researchanddesire/rad-project-template/hardware/cad/README.md

# CAD

Place mechanical source files and exports for PRODUCT_NAME here.

Prefer source files or reproducible exports that can be linked from
`hardware/bom.csv`.
