researchanddesire/rad-project-template/developer-docs/docs/index.md

# Buttplug Compass

Start with the [manufacturing design proposal](prototype-build-handoff.md).
It replaces the earlier scaffold with four main mechanical pieces: CNC-turned body,
CNC-turned motor/thermistor cap, open flange tray and rear cover. A separate silicone boot
and standard insulation/foam remain part of the assembly.

| Page | Use it for |
| --- | --- |
| [Design proposal](prototype-build-handoff.md) | Current structure, assembly and unresolved interfaces |
| [Requirements](prd.md) | Lucy's feature and packaging constraints |
| [Architecture](architecture.md) | Mechanical, power and signal paths |
| [Hardware](hardware.md) | Current native CAD, exports and electrical references |
| [Firmware](firmware.md) | Existing bench code and compatibility limits |
| [Validation](testing.md) | Evidence, limits and required next checks |

The previous P1 dry-fit kit is withdrawn as the recommended build. The new CAD
is a manufacturing study, not a build/tooling release. Battery choice is open.
No physical build, powered operation or wear validation exists.

[Archived studies](archive/index.md) are for targeted historical lookup.
Update these current pages in place; use Git history rather than revision logs.
