researchanddesire/rad-project-template/developer-docs/docs/archive/index.md

---
search:
  exclude: true
---

# Archived design studies

These are dated snapshots, superseded concepts and detailed investigation
records. Their phrases such as “current” or “latest” refer to the time they
were written. They do not override the [current build proposal](../prototype-build-handoff.md).

| Topic | Selected historical records |
| --- | --- |
| Shape and construction | [Pelvic contour](design-proposal-v3.md), [metal/polymer direction](materials-and-rf-study.md) |
| One-piece/front loading | [R9](front-load-study-r9.md), [carrier](front-load-carrier-r10.md) |
| Independent motor and tip | [Shell mount](motor-shell-mount-r25.md), [stationary tip](tip-support-r26.md) |
| Boards and interconnect | [Split circuit](split-circuit-r14.md), [pack lands](pack-connection-r34.md) |
| Flange, controls and battery | [Rotated cradle](flange-cradle-r27.md), [buttons](buttons-r31.md), [pack tray](flange-pack-r33.md) |
| Superseded retention | [Shared motor/PCB keeper](motor-retention-r21.md), [sensor comb](sensor-retention-r38.md) |

Other revision pages are retained in this folder for targeted lookup and are
excluded from normal site search/navigation. Old source paths and hash manifests
may describe the pre-cleanup tree; use Git history for that snapshot. Native
hardware sources remain under `hardware/`, not in this documentation archive.

Do not copy this history back into current pages or append a running revision
log. Update the current design in place; Git records those changes. Some notes
were still uncommitted during cleanup, so they are preserved here rather than
assuming they already exist in Git history.
