researchanddesire/rad-project-template/developer-docs/docs/assets/compass-prd-layout-fixed.png

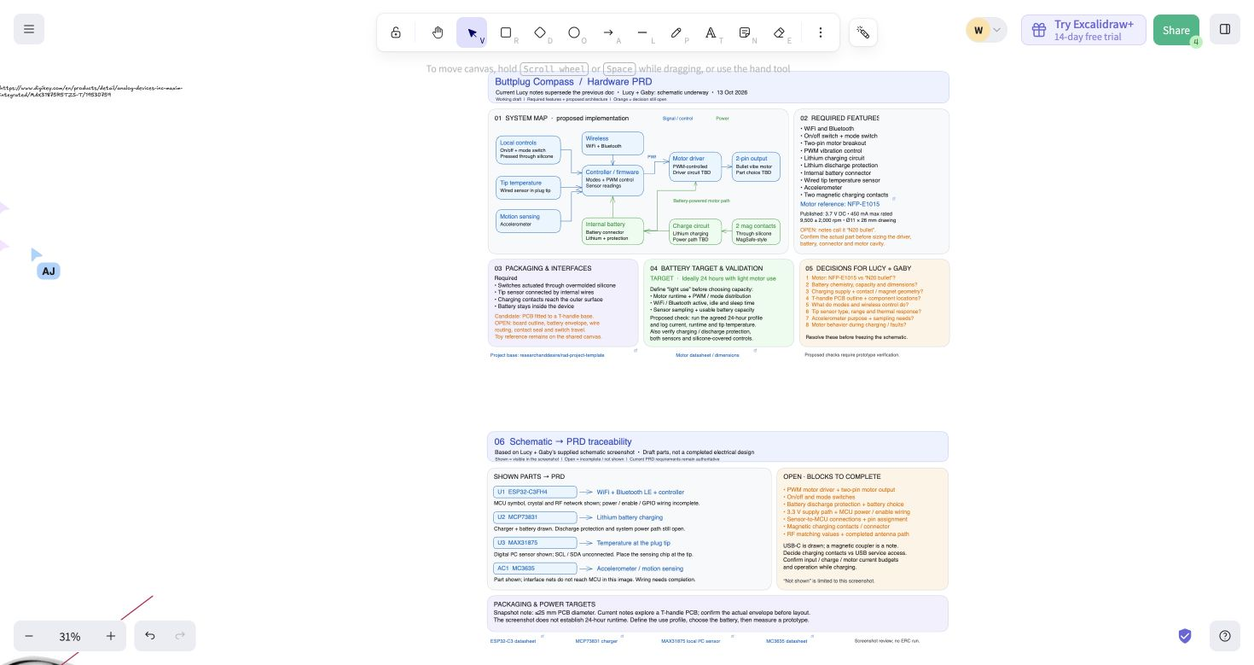
developer-docs/docs/assets/compass-prd-layout-fixed.png
