researchanddesire/rad-project-template/developer-docs/docs/assets/concept-v3/contour-v3.png

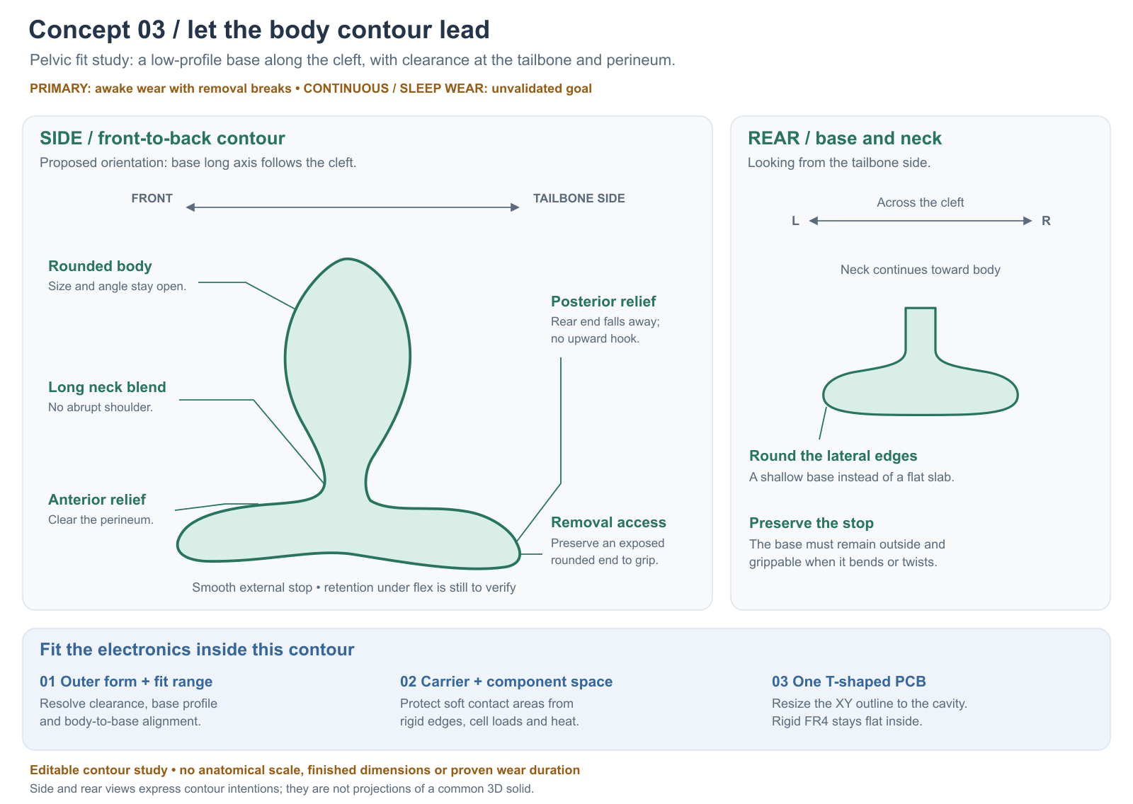
developer-docs/docs/assets/concept-v3/contour-v3.png
