researchanddesire/rad-project-template/developer-docs/docs/assets/prototype-p1-cover.png

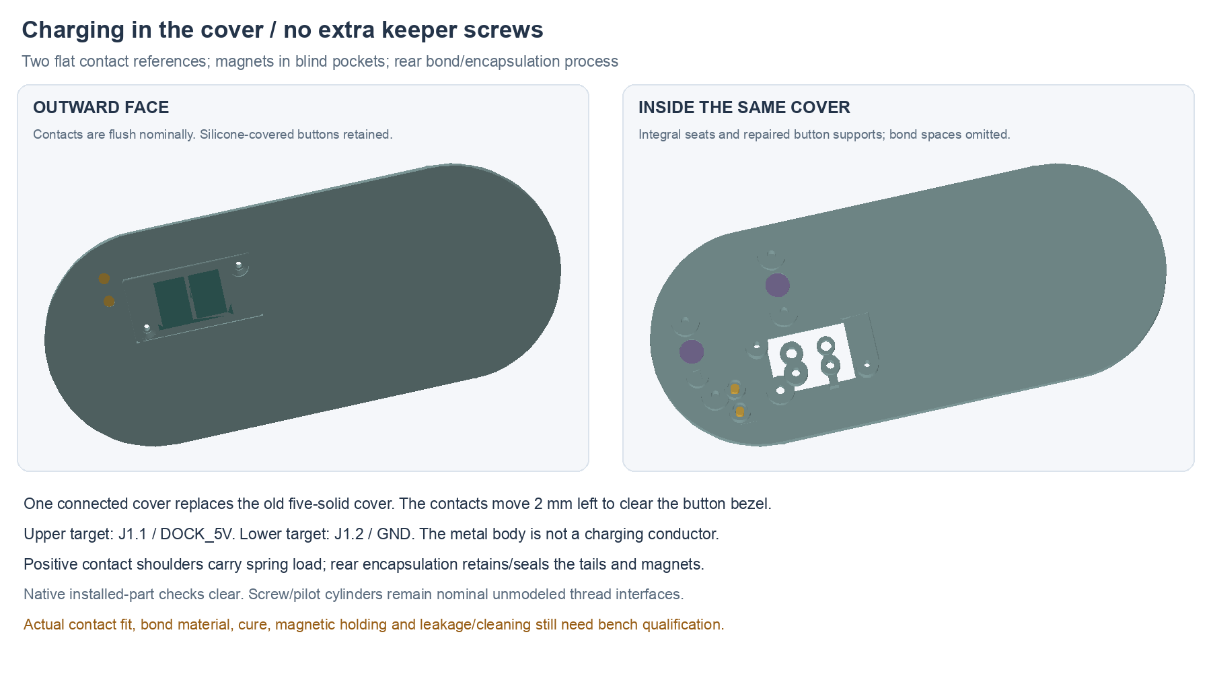
developer-docs/docs/assets/prototype-p1-cover.png
