researchanddesire/rad-project-template/developer-docs/docs/assets/prototype-p1-dry-fit.png

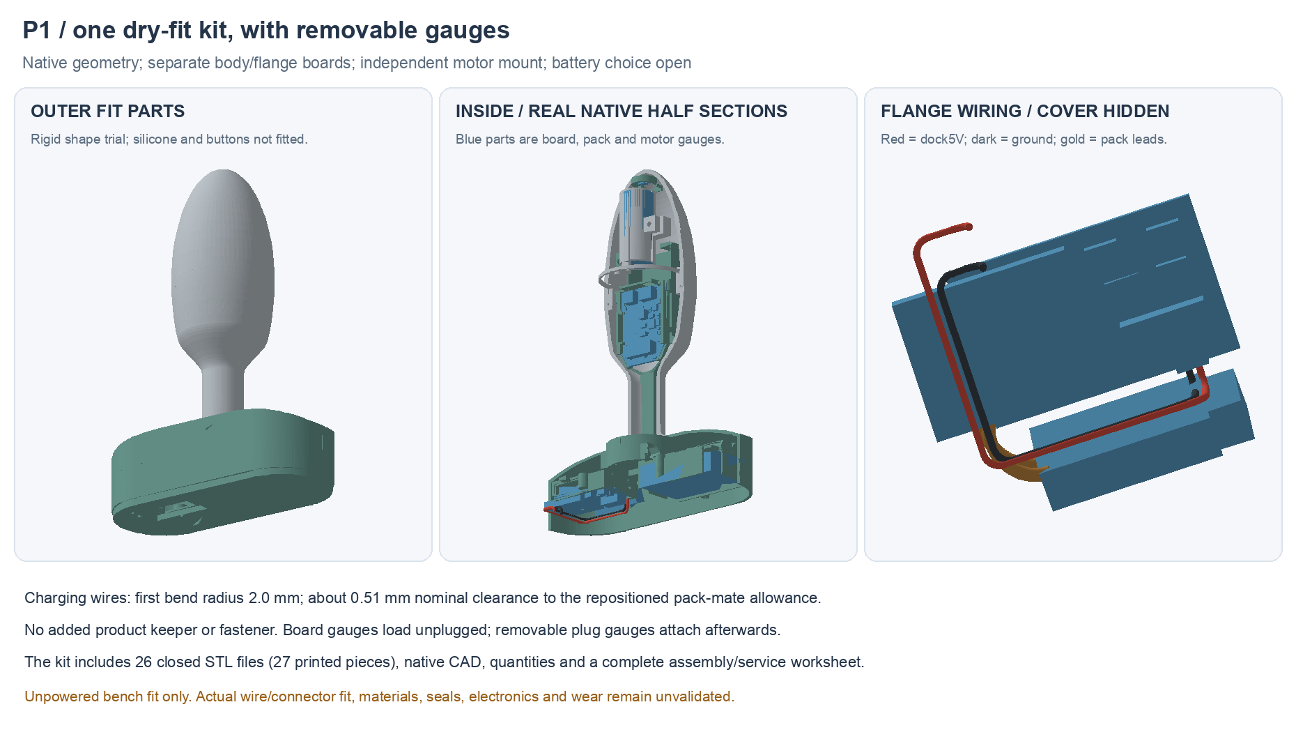
developer-docs/docs/assets/prototype-p1-dry-fit.png
