researchanddesire/rad-project-template/developer-docs/docs/assets/prototype-p1.png

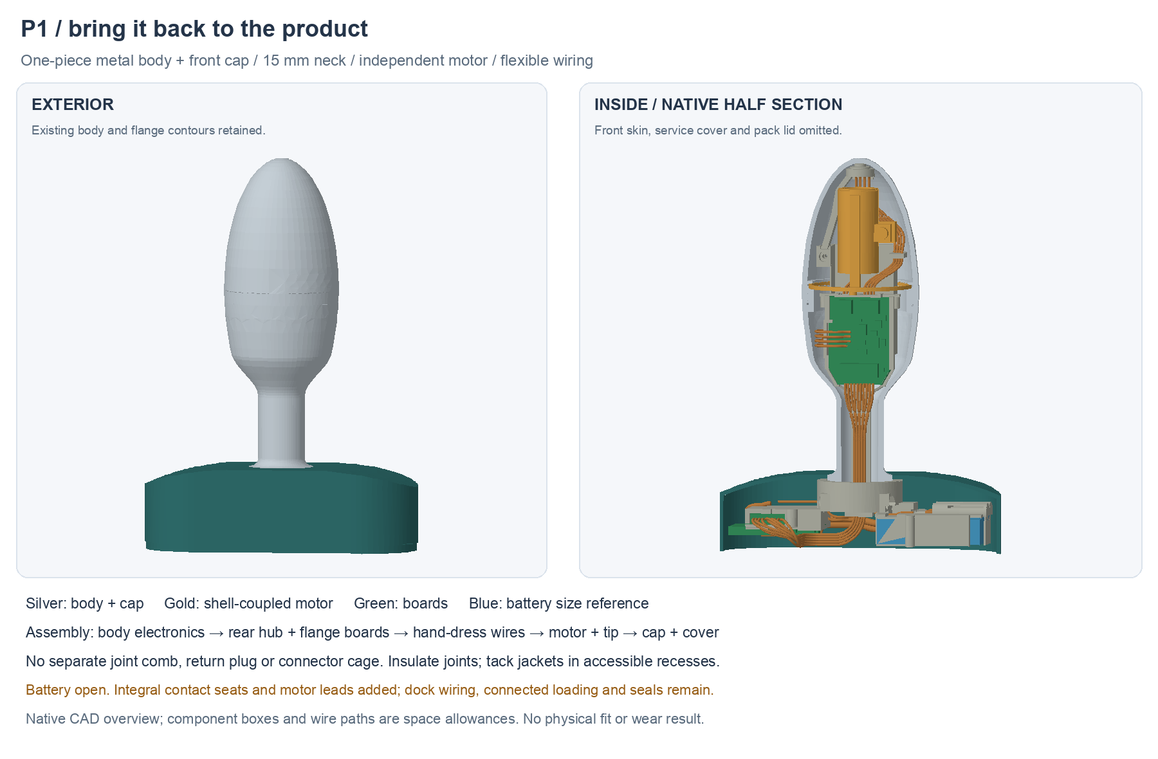
developer-docs/docs/assets/prototype-p1.png
