researchanddesire/rad-project-template/developer-docs/docs/assets/prototype-r0/mechanical-r0.png

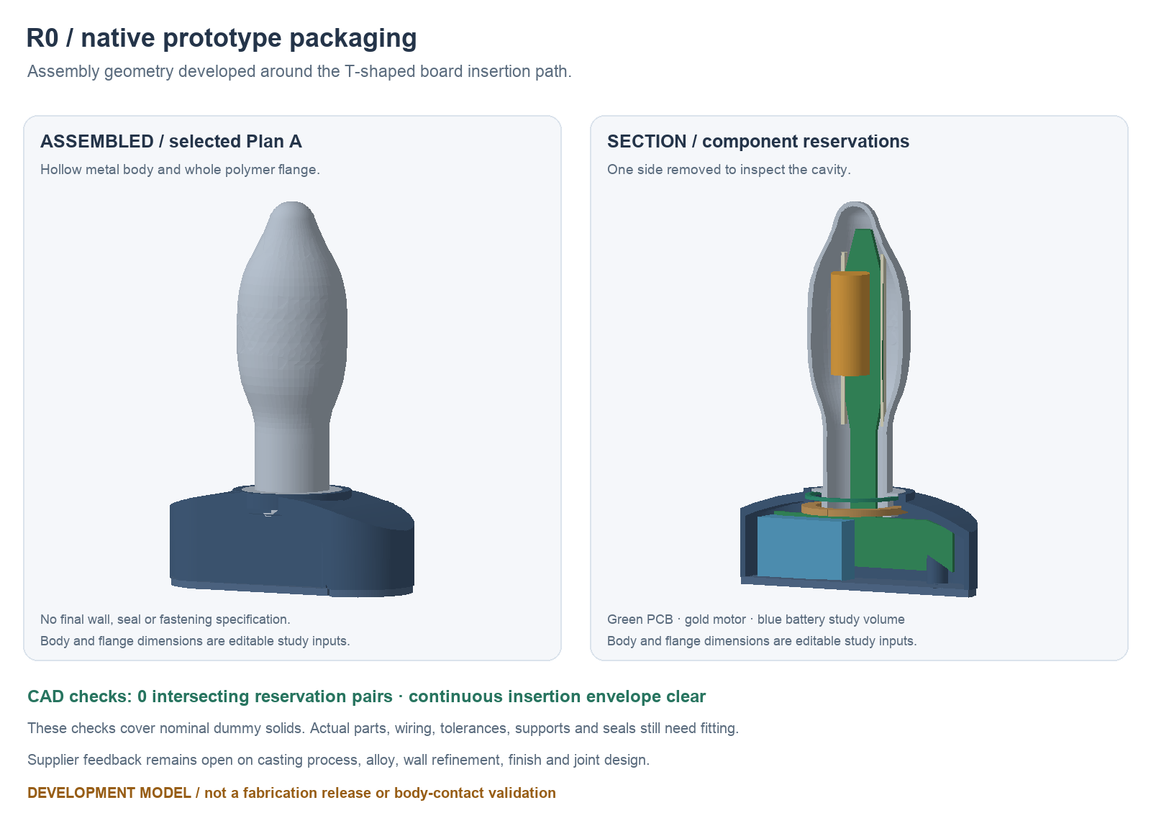
developer-docs/docs/assets/prototype-r0/mechanical-r0.png
