researchanddesire/rad-project-template/assembly-docs/bom.md

---
hide:
  - toc
---
# Bill of Materials

This parts list is generated from [`hardware/bom.csv`](../hardware/bom.csv)
during the assembly-docs build. Do not edit the generated block by hand. Update
the CSV instead.

<!-- BEGIN GENERATED BOM -->
<!-- END GENERATED BOM -->

## Assembly Tools and Shop Supplies

| Item | Use |
| ---- | --- |
| TBD | TBD |
