researchanddesire/rad-project-template/developer-docs/docs/assets/material-study-v1/materials-and-rf.png

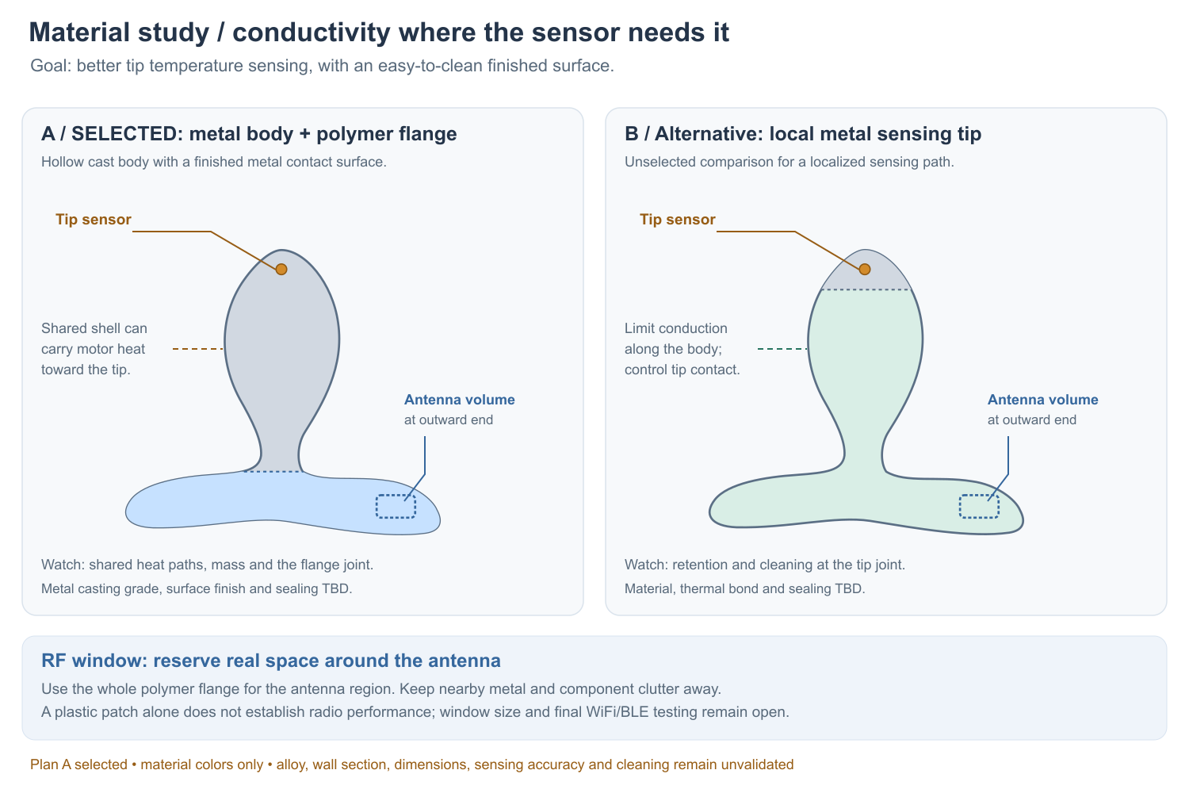
developer-docs/docs/assets/material-study-v1/materials-and-rf.png
