researchanddesire/rad-project-template/hardware/cad/manufacturing-layout/FlangeTray.step

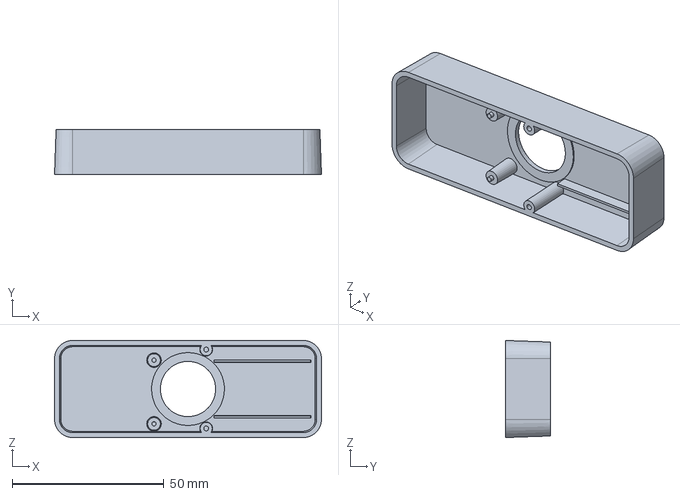
[picture p53: CAD file, 2026-11-03]
hardware/cad/manufacturing-layout/FlangeTray.step
88.0 x 14.9 x 32.0 mm
