researchanddesire/rad-project-template/hardware/cad/prototype-p1/PrototypeP1.FCStd

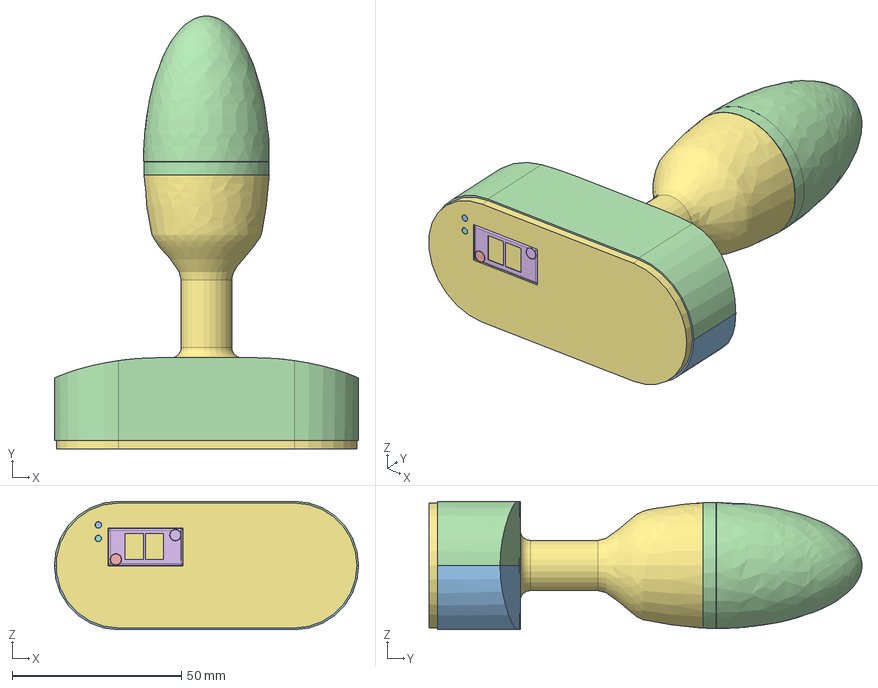
[picture p54: CAD file, 2026-11-03]
hardware/cad/prototype-p1/PrototypeP1.FCStd
90.0 x 128.1 x 38.0 mm
BodyPCB_R17
Body28AWG bareD0.4 process allowance
Body28AWG bareD0.4 process allowance001
PACK_P / unchanged body/anchor prefix; loose-end forming after hub closure
GND_POWER / unchanged body/anchor prefix; loose-end forming after hub closure
Flush countersunk bezel / silicone strip retainer
Installed compressed silicone lid / material, return and seal unqualified
ButtonHomePinR31_SW1
ButtonHomePinR31_SW2
ButtonKeeperR31
ButtonPlungerR31_SW1
ButtonPlungerR31_SW2
ButtonRetainerScrewR31_1
ButtonRetainerScrewR31_2
ButtonStopScrewR31_SW1
ButtonStopScrewR31_SW2
Mold around actual wires / compliant anchor / grade and bond unqualified
Factory bare lead offset -0.45Y for separate solder lap / D0.4 budget
Factory bare lead offset -0.45Y for separate solder lap / D0.4 budget001
Factory bare lead offset -0.45Y for separate solder lap / D0.4 budget002
Factory bare lead offset -0.45Y for separate solder lap / D0.4 budget003
GND_SENSE / factory OD1.2 allowance / soldered adapter candidate
PACK_NTC / factory OD1.2 allowance / soldered adapter candidate
PACK_GUARD / factory OD1.2 allowance / soldered adapter candidate
GND_SENSE / factory OD1.2 allowance / soldered adapter candidate001
Mold around actual wires / keeper-captured anchor / grade and bond unqualified
Exact source cover reference; central hub moved below roof; controls/wing/seals not qualified
Exact source cover reference; central hub moved below roof; controls/wing/seals not qualified001
M1.6x6 candidate / headD3.2 allowance / polymer pilot unqualified
FlangePCB_R17
Nominal M2x20 budget, installed from left with skin/PCB waiting; actual drive/thread/torque open001
Nominal M2x20 budget, installed from left with skin/PCB waiting; actual drive/thread/torque open
Nominal4AFx1.6 M2nut in side-load pocket; real bought part/fit unselected001
Nominal4AFx1.6 M2nut in side-load pocket; real bought part/fit unselected
1 / GND / 28AWG candidate OD0.60 allowance
10 / ACCEL_INT_N / 28AWG candidate OD0.60 allowance
2 / VBUS_CHG / 28AWG candidate OD0.60 allowance
3 / 3V3 / 28AWG candidate OD0.60 allowance
4 / PACK_P / 28AWG candidate OD0.60 allowance
5 / MOTOR_ARM / 28AWG candidate OD0.60 allowance
6 / MOTOR_PWM / 28AWG candidate OD0.60 allowance
7 / DOCK_PRESENT_N / 28AWG candidate OD0.60 allowance
8 / I2C_SDA / 28AWG candidate OD0.60 allowance
9 / I2C_SCL / 28AWG candidate OD0.60 allowance
KeeperScrew1
KeeperScrew_1
KeyedBodyR25
MotorClampNutR25
MotorClampScrewR25
MotorLeadFlareAllowanceR21
MotorMaxEnvelope
MotorSeatCapR25
Solder-process target within D1.4 envelope; bare-core budgets subtracted
Solder-process target within D1.4 envelope; bare-core budgets subtracted001
Solder-process target within D1.4 envelope; bare-core budgets subtracted002
Solder-process target within D1.4 envelope; bare-core budgets subtracted003
Insulated lap-joint OD1.8 x5 PROCESS BUDGET / not qualified part
Insulated lap-joint OD1.8 x5 PROCESS BUDGET / not qualified part001
Insulated lap-joint OD1.8 x5 PROCESS BUDGET / not qualified part002
Insulated lap-joint OD1.8 x5 PROCESS BUDGET / not qualified part003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
