researchanddesire/rad-project-template/hardware/cad/manufacturing-layout/MotorThermistorCap.step

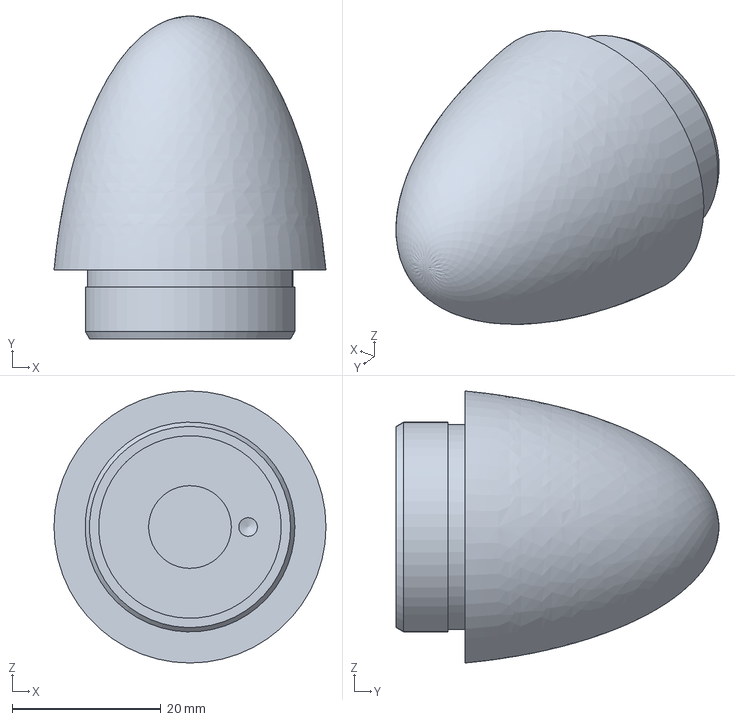
[picture p55: CAD file, 2026-11-03]
hardware/cad/manufacturing-layout/MotorThermistorCap.step
36.5 x 43.3 x 36.5 mm
