researchanddesire/rad-project-template/hardware/cad/manufacturing-layout/MetalBody.step

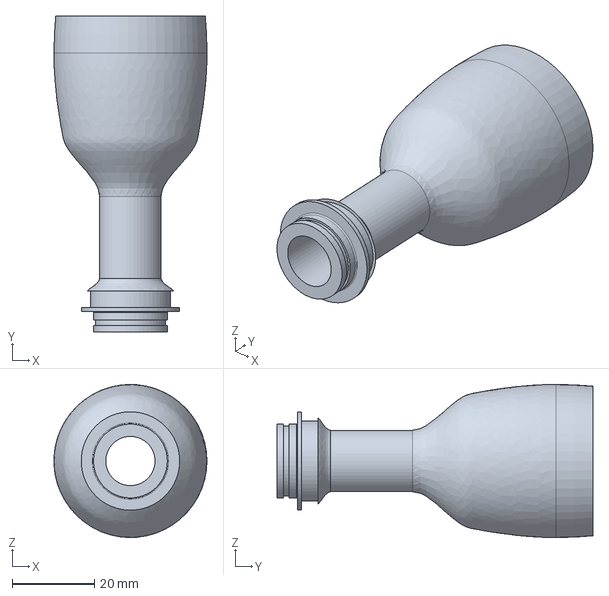
[picture p56: CAD file, 2026-11-03]
hardware/cad/manufacturing-layout/MetalBody.step
37.3 x 77.0 x 37.3 mm
