researchanddesire/rad-project-template/hardware/cad/manufacturing-layout/ManufacturingLayout.FCStd

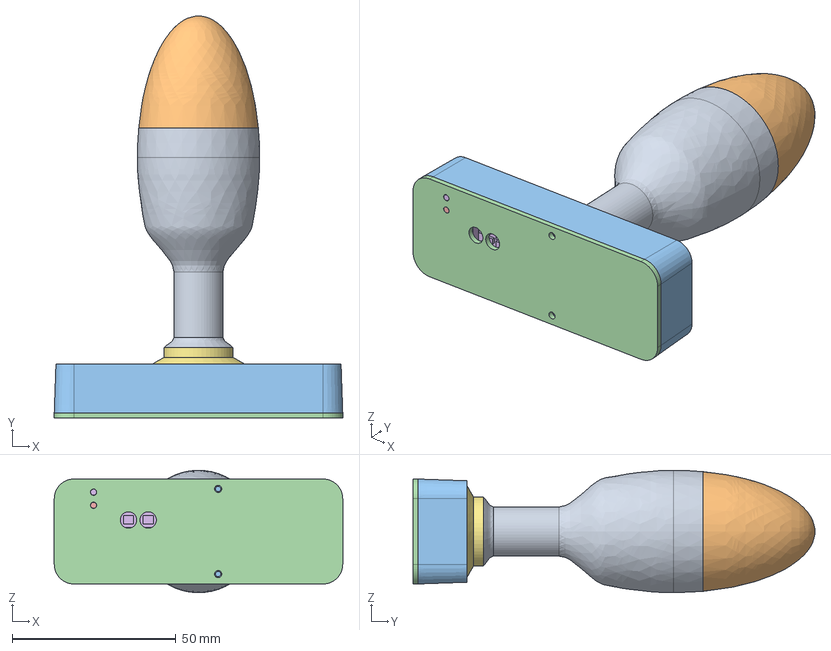
[picture p57: CAD file, 2026-11-03]
hardware/cad/manufacturing-layout/ManufacturingLayout.FCStd
88.0 x 122.6 x 37.3 mm
MetalBody
MotorThermistorCap
FlangeTray
RearCover
BodyElectronicsReference
FlangeElectronicsMechanicalProposal
UnselectedPackReference
MotorReferenceFitTBD
TipThermistorHeadReference
TipPottingProcessSpace
PackNTCReference1
PackNTCReference2
GroundTargetReference
PositiveTargetReference
MagnetReference0
MagnetReference1
StandardRetainingRingEnvelope
OpenEndedInsulatingSleeve
StandardFoamSpacerLeft
StandardFoamSpacerRight
CapFaceSealProcessSpace
RootSocketBondProcessSpace
BondedBootCuffProcessSpace
