researchanddesire/rad-project-template/hardware/cad/manufacturing-layout/RearCover.step

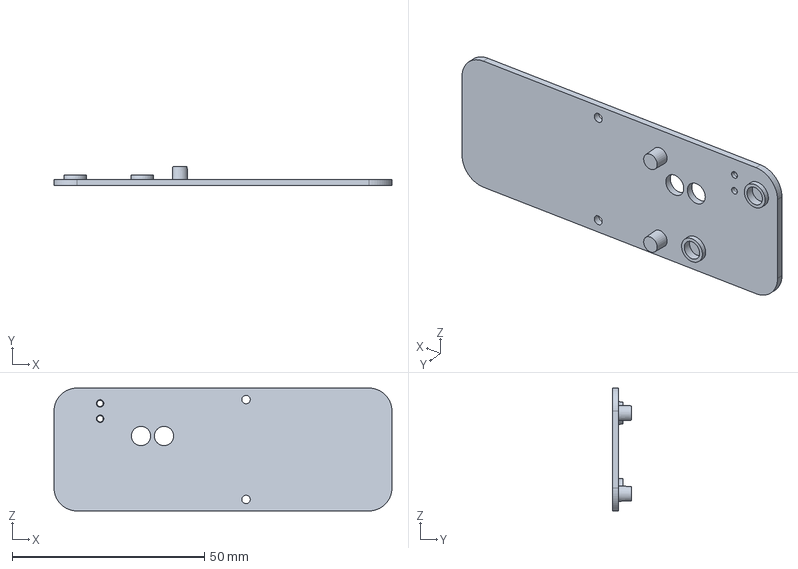
[picture p58: CAD file, 2026-11-03]
hardware/cad/manufacturing-layout/RearCover.step
88.0 x 4.99 x 32.0 mm
