researchanddesire/rad-project-template/(list of files, cad)

Other CAD files:
hardware/cad/manufacturing-layout/archive/PreviousManufacturingLayout.FCStd
hardware/cad/manufacturing-layout/FlangeTray.stl
hardware/cad/manufacturing-layout/RearCover.stl
