researchanddesire/rad-project-template/assembly-docs/index.md

# Assembly documentation

The current manufacturing direction uses two CNC-turned metal parts—body and motor/thermistor cap—plus an
open flange tray and rear cover, plus a silicone outer boot. Start with the
[assembly direction](assembly-guide.md) and the native CAD/README under
`hardware/cad/manufacturing-layout/`.

This is not a released build. The earlier scaffold/P1 fit kit is superseded.
The NTC circuit/firmware, PCB tabs, rotating module loom, cap thread/seals,
boot/buttons and matching charger still need integration and validation.

- [PCB reference](pcb-overview.md)
- [Harness reference](cable-harnesses.md)
- [Human-owned BOM](bom.md)

Earlier module pages are historical/reference studies, not current build steps.
No component is approved for purchase by appearing in a diagram or CAD model.
