researchanddesire/rad-project-template/hardware/cad/manufacturing-layout/archive/README.md

# Superseded manufacturing study

This preserves unique uncommitted CAD from before the two-piece CNC turning
review. It used rear metal screw pilots and a deep cap pocket/keyway. It is
not the current design or a build recommendation. Use the parent folder.
