researchanddesire/rad-project-template/(list of files, drawings)

Other design files:
developer-docs/docs/assets/prototype-r2/pcb-assembly-process-r1-source.json
developer-docs/docs/assets/prototype-r2/pcb-integration-r18-b-source.json
developer-docs/docs/assets/prototype-r2/pcb-integration-r18-source.json
developer-docs/docs/assets/prototype-r2/pcb-integration-r20-d-source.json
