researchanddesire/rad-project-template/hardware/pcb/pack-pigtail-r35/candidate-f/body/body-r35.kicad_pcb

## KiCad design hardware/pcb/pack-pigtail-r35/candidate-f/body/body-r35.kicad_pcb (2026-11-03)

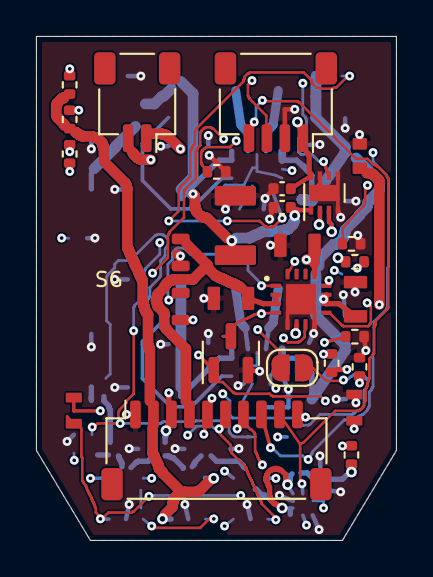
[picture p62: board body-r35.kicad_pcb from above]

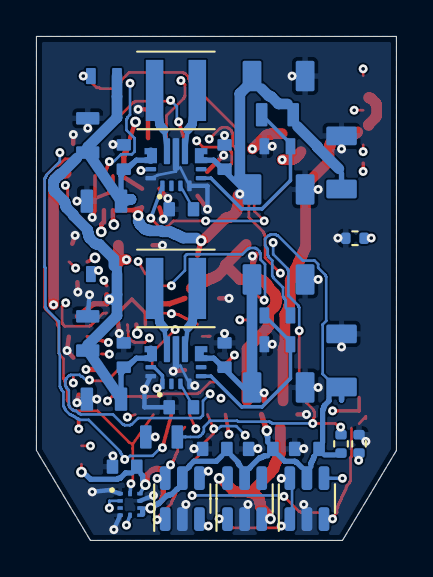
[picture p63: board body-r35.kicad_pcb from below]

Board: 6 copper layers, 20.0 x 28.0 mm, 65 parts (38 on the bottom side), 36 nets.

Parts:
C1, C2: GRM21BR71A475KA73L; Murata_GRM21_0805_Reflow
C3, C11, C12, C21, C22: GRM21BR61A106KE19L; Murata_GRM21_0805_Reflow
C13, C14, C15, C23, C24, C25: GRM31CR71A226KE15L; Murata_GRM31_1206_Reflow
C16, C26, C27, C41, C42, C43, C44: GRM188R71C104KA01D; Murata_GRM18_0603_Reflow
C28, C29: GRM155R71C104KA88D candidate; C_0402_1005Metric
C30: GRM32ER61A476KE20L; Murata_GRM32_1210_Reflow
C51, C52, C53, C54: C1608X5R1A106K080AC; TDK_C1608_0603_Reflow
J2: PACK_PIGTAIL_4NET_5LAND; Pack_Pigtail_4Net_5Land
J3: SM02B-SRSS-TB; JST_SH_SM02B-SRSS-TB_1x02-1MP_P1.00mm_Horizontal
J5: SM04B-SRSS-TB; JST_SH_SM04B-SRSS-TB_1x04-1MP_P1.00mm_Horizontal
J6: SM10B-SRSS-TB candidate; JST_SH_SM10B-SRSS-TB_1x10-1MP_P1.00mm_Horizontal
JP1: PCB solder jumper / open; SolderJumper-2_P1.3mm_Open_RoundedPad1.0x1.5mm
L1, L2: XFL4020-152MEC; L_Coilcraft_XxL4020
Q1: AO3400A; SOT-23
R1: TNPW04028K87BEED; R_0402_1005Metric
R2: TNPW04023K24BEED; R_0402_1005Metric
R3, R4, R5, R42: TNPW040210K0BEED; R_0402_1005Metric
R11: TNPW0603312KBEEA; Vishay_TNPW0603_IEC_Reflow
R12, R22: TNPW0603100KBEEA; Vishay_TNPW0603_IEC_Reflow
R13, R26: TNPW060310K0BEEA; Vishay_TNPW0603_IEC_Reflow
R21: TNPW0805362KBEEA; Vishay_TNPW0805_IEC_Reflow
R23, R24, R25, R48: TNPW0402100KBEED; R_0402_1005Metric
R41: TNPW04024K70BEED; R_0402_1005Metric
R43: TNPW0805715KBEEA; Vishay_TNPW0805_IEC_Reflow
R44: TNPW0603110KBEEA; Vishay_TNPW0603_IEC_Reflow
R45: TNPW0603200KBEEA; Vishay_TNPW0603_IEC_Reflow
R46: TNPW040211K0BEED; R_0402_1005Metric
R47: TNPW04021K00BEED; R_0402_1005Metric
U1: BQ24074RGT; TI_RGT0016C_3x3mm_BQ24074_EP1.68mm
U2, U3: TPS63070RNM; TI_RNM0015A_2.5x3mm_TPS63070
U4: SN74LVC1G11DBVR; SOT-23-6
U5: DRV8212DSGR; WSON-8-1EP_2x2mm_P0.5mm_EP0.9x1.6mm
U7: MC3635; MEMSIC_MC3635_LGA10_1.6x1.6mm_P0.4mm
U8: TPS3700DDCR; TSOT-23-6
U9: TPS3808G33DBVR; SOT-23-6

Connections:
3V3: C13.1, C14.1, C15.1, C27.1, C29.1, C41.1, C42.1, C43.1, C52.1, J5.1, J6.3, R4.1, R5.1, R11.1, R41.1, R42.1, U2.7, U2.8, U4.5, U5.8, U7.6, U7.7, U7.9, U8.5, U9.5
ACCEL_INT_N: J6.10, R41.2, U7.5
CHARGE_CE_N: Q1.3, R3.2, U1.4
CHARGE_GATE: Q1.1, R47.2, R48.1
CHARGE_PERMIT: JP1.2, R47.1
CHARGE_STATUS_N: R5.2, U1.9
CHARGE_TEMP_OK: JP1.1, R46.2, U8.1, U8.6, U9.1
CHG_ILIM: R2.1, U1.12
CHG_ISET: R1.1, U1.16
DOCK_PRESENT_N: J6.7, R4.2, U1.7, U4.6
GND: C1.2, C2.2, C3.2, C11.2, C12.2, C13.2, C14.2, C15.2, C16.2, C21.2, C22.2, C23.2, C24.2, C25.2, C26.2, C27.2, C28.2, C29.2, C30.2, C41.2, C42.2, C43.2, C44.2, C51.2, C52.2, C53.2, C54.2, J2.2, J5.2, J6.1, Q1.2, R1.2, R2.2, R12.2, R22.2, R23.2, R24.2, R25.2, R45.2, R48.2, U1.5, U1.8, U1.17, U2.4, U2.10, U2.15, U3.4, U3.10, U3.15, U4.2, U5.4, U5.5, U5.7, U5.9, U7.1, U7.4, U7.8, U8.2, U9.2
I2C_SCL: J5.4, J6.9, U7.10
I2C_SDA: J5.3, J6.8, U7.2
MOTOR_3V7: C23.1, C24.1, C25.1, C28.1, C30.1, C54.1, R21.1, U3.7, U3.8, U5.1
MOTOR_ARM: J6.5, R23.1, U3.14, U4.3
MOTOR_IN1: R25.1, U4.4, U5.6
MOTOR_N: J3.2, U5.3
MOTOR_P: J3.1, U5.2
MOTOR_PWM: J6.6, R24.1, U4.1
PACK_GUARD: J2.4, R42.2, R43.1
PACK_NTC: J2.3, U1.1
PACK_P: C2.1, J2.1, J6.4, U1.2, U1.3
REG1_AUX: C16.1, U2.3
REG1_FB: R11.2, R12.1, U2.5
REG1_L1: L1.1, U2.11
REG1_L2: L1.2, U2.9
REG1_PS: R13.2, U2.1, U2.14
REG2_AUX: C26.1, U3.3
REG2_FB: R21.2, R22.1, U3.5
REG2_L1: L2.1, U3.11
REG2_L2: L2.2, U3.9
REG2_PS: R26.2, U3.1
SYS: C3.1, C11.1, C12.1, C21.1, C22.1, C51.1, C53.1, R13.1, R26.1, U1.10, U1.11, U2.12, U2.13, U3.12, U3.13
TEMP_COLD_IN: R44.2, R45.1, U8.4
TEMP_HOT_IN: R43.2, R44.1, U8.3
VBUS_CHG: C1.1, C44.1, J6.2, R3.1, R46.1, U1.6, U1.13, U9.3, U9.6
