researchanddesire/rad-project-template/hardware/pcb/pack-pigtail-r35/candidate-f/flange/flange-r35.kicad_pcb

## KiCad design hardware/pcb/pack-pigtail-r35/candidate-f/flange/flange-r35.kicad_pcb (2026-11-03)

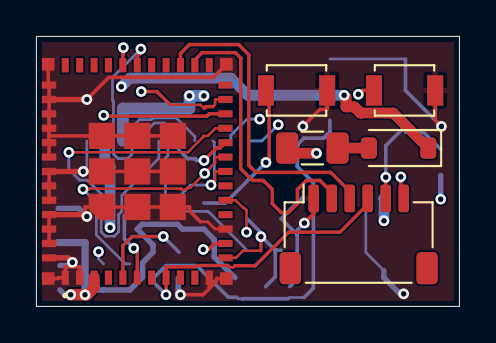
[picture p64: board flange-r35.kicad_pcb from above]

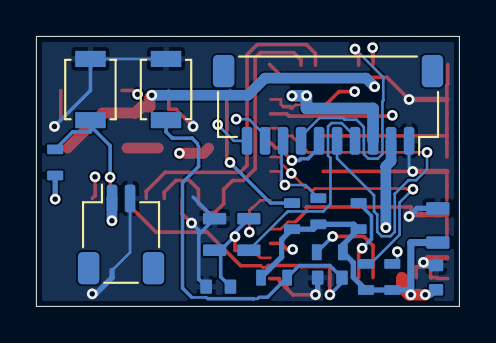
[picture p65: board flange-r35.kicad_pcb from below]

Board: 4 copper layers, 23.5 x 15.0 mm, 24 parts (18 on the bottom side), 22 nets.

Parts:
C31: GRM21BR61A106KE19L; Murata_GRM21_0805_Reflow
C32, C34: GRM188R71C104KA01D; Murata_GRM18_0603_Reflow
C33: C1608X7R1E105K080AB; TDK_C1608_0603_Reflow
D1: B140HW-7; Diodes_B140HW_SOD123_A1_K2
F1: 1206L050YR; Fuse_1206_3216Metric
J1: SM02B-SRSS-TB; JST_SH_SM02B-SRSS-TB_1x02-1MP_P1.00mm_Horizontal
J4: SM06B-SRSS-TB; JST_SH_SM06B-SRSS-TB_1x06-1MP_P1.00mm_Horizontal
J7: SM10B-SRSS-TB candidate; JST_SH_SM10B-SRSS-TB_1x10-1MP_P1.00mm_Horizontal
R31, R32, R33, R34, R35, R36: TNPW060310K0BEEA; Vishay_TNPW0603_IEC_Reflow
R37, R38: TNPW06034K70BEEA; Vishay_TNPW0603_IEC_Reflow
R39, R40: TNPW08051M00BEEA; Vishay_TNPW0805_IEC_Reflow
SW1, SW2, SW3, SW4: B3U-1000P; SW_SPST_B3U-1000P
U6: ESP32-C3-MINI-1-N4X; Espressif_ESP32-C3-MINI-1_53Pads

Connections:
3V3: C31.1, C32.1, J7.3, R31.1, R32.1, R33.1, R34.1, R35.1, R36.1, R37.1, R38.1, U6.3
ACCEL_INT_N: J7.10, U6.16
BOOT_N: J4.5, R34.2, SW4.1, U6.23
DOCK_5V: F1.1, J1.1
DOCK_FUSED: D1.1, F1.2
DOCK_PRESENT_N: J7.7, U6.30
GND: C31.2, C32.2, C33.2, C34.2, J1.2, J4.1, J7.1, R40.2, SW1.2, SW2.2, SW3.2, SW4.2, U6.1, U6.2, U6.11, U6.14, U6.36, U6.37, U6.38, U6.39, U6.40, U6.41, U6.42, U6.43, U6.44, U6.45, U6.46, U6.47, U6.48, U6.49, U6.50, U6.51, U6.52, U6.53
I2C_SCL: J7.9, R38.2, U6.19
I2C_SDA: J7.8, R37.2, U6.18
MCU_EN: C33.1, J4.4, R31.2, SW3.1, U6.8
MODE_N: R36.2, SW2.1, U6.6
MOTOR_ARM: J7.5, U6.21
MOTOR_PWM: J7.6, U6.20
PACK_P: J7.4, R39.1
POWER_N: R35.2, SW1.1, U6.13
STRAP2: R32.2, U6.5
STRAP8: R33.2, U6.22
UART_TX: J4.6, U6.31
USB_DM: J4.2, U6.26
USB_DP: J4.3, U6.27
VBAT_ADC: C34.1, R39.2, R40.1, U6.12
VBUS_CHG: D1.2, J7.2
