researchanddesire/rad-project-template/tools/index_pack_sensor_r36.py

"""Bind connected-H/service-I sensor review artifacts, keeping the full goal open."""
from pathlib import Path
from datetime import datetime,timezone
import hashlib,json
ROOT=Path(__file__).resolve().parents[1];H=ROOT/'hardware/cad/pack-sensor-r36/connected-h';I=ROOT/'hardware/cad/pack-sensor-r36/access-i';C=ROOT/'hardware/cables/pack-sensor-r36';sha=lambda p:hashlib.sha256(p.read_bytes()).hexdigest()
h=json.loads((H/'geometry-report.json').read_text());hv=json.loads((H/'saved-review.json').read_text());i=json.loads((I/'access-review.json').read_text());iv=json.loads((I/'saved-access-review.json').read_text());c=json.loads((C/'logical-review.json').read_text());assert sha(H/'ConnectedPackSensorsR36.FCStd')==h['native_sha256']==hv['native_sha256']==i['source_connected_H_sha256']==iv['source_H_sha256'];assert sha(I/'ServiceablePackSensorsR36.FCStd')==i['native_sha256']==iv['native_sha256'];assert h['all_static_screens_clear']and hv['all_reviewed_screens_clear']and i['all_listed_tool_poses_clear']and iv['all_source_physical_geometry_conserved'];assert c['recipe_sha256']==sha(C/'pack-sensor-r36.yml')and c['separate_external_power_and_sensor_returns'];assert sha(ROOT/'hardware/bom.csv')=='d5424d0536840bd3b555c439a129c0271b19b1cfbb3b94f1e1709e57cd63f05c'
files={}
for folder in [H,I,C]:
 for p in sorted(folder.rglob('*')):
  if p.is_file()and p.suffix not in ['.pyc','.kicad_prl']and p.name!='.DS_Store':files[str(p.relative_to(ROOT))]=sha(p)
bindings=['hardware/cad/pack-sensor-r36/README.md','hardware/cad/pack-sensor-r36/candidate-c/PackSensorRouteR36.FCStd','hardware/cad/pack-sensor-r36/candidate-c/geometry-report.json','hardware/design/pack-harness-r34/current-review.json','hardware/pcb/pack-pigtail-r35/candidate-f/system-native.xml','hardware/pcb/pack-pigtail-r35/candidate-f/body/body-r35.kicad_pcb','hardware/pcb/pack-pigtail-r35/candidate-f/saved-circuit-review.json','developer-docs/docs/pack-sensor-r36.md','assembly-docs/pack-sensor-r36.md','developer-docs/docs/assets/prototype-r2/pack-sensor-r36-h.png','developer-docs/docs/assets/prototype-r2/pack-sensor-r36-h-source.json','hardware/design/pack-sensor-r36/power-reference-notes.json','tools/review_pack_sensor_net_r36.py','hardware/bom.csv']
external={p:sha(ROOT/p)for p in bindings}
out={'indexed_at_utc':datetime.now(timezone.utc).isoformat(),'indexer_sha256':sha(Path(__file__)),'files_sha256':files,'external_bindings_sha256':external,'current':{'sensor_wiring':'R36 connected H','service_opening':'R36 access I','electrical_partner':'R35 candidate F','battery_selection':'OPEN'},'checks':{'installed_comparisons':h['static_pairs'],'source_physical_roles_conserved':hv['source_role_count'],'moved_sensor_pairs':hv['fresh_moved_sensor_pairs'],'reservation_pairs':hv['sizing_and_head_reservation_pairs'],'distinct_lap_minimum_gap_mm':min(q['bare_core_gap_mm']for q in hv['separate_lap_core_checks']),'listed_generic_tool_poses':sum(len(q['poses'])for q in i['generic_tool_probes']),'service_source_geometry_roles_conserved':iv['source_physical_role_count'],'recipe_matches_native_nets':True},'prototype_build_consideration_ready':False,'remaining_design':['Protected-pack power mate, actual lead exit/reference and independent restraint','Positive force bypass and retention for body solder lands, return junction and four lap joints','Matched solder/insulation/attachment process and connected loading/service/cover sequence','Remaining motor/dock harness, flange load/compliance and seal/material/process work','Consolidated native/exports, fabrication review and practical first-build/commissioning package'],'temporary_review_outputs':'WireViz SVG/PNG/child BOM under /private/tmp/r36-wireviz; regenerate from recipe. These are not stored or required as permanent repository files.','scope':'Integrity record for completed installed sensor paths and service-access study only. Process budgets/nominal gaps/generic probes are not physical or manufacturing acceptance; pack power mate and the full prototype proposal remain unfinished. No purchase, commit, BOM adoption or live battery work.'}
p=ROOT/'hardware/design/pack-sensor-r36/current-review.json';p.write_text(json.dumps(out,indent=2)+'\n');print('Indexed',len(files),'current files and',len(external),'external bindings; full prototype goal remains open.',flush=True)
