researchanddesire/rad-project-template/tools/index_sensor_retention_r38.py

"""Bind R38's scoped retention checkpoint while keeping the full goal open."""
from pathlib import Path
from datetime import datetime,timezone
import hashlib,json
ROOT=Path(__file__).resolve().parents[1];P=ROOT/'hardware/cad/joint-retention-r38/sensor-c';sha=lambda p:hashlib.sha256(p.read_bytes()).hexdigest();r=json.loads((P/'geometry-report.json').read_text());v=json.loads((P/'loading-review.json').read_text());e=json.loads((P/'exchange/exchange-review.json').read_text());c=json.loads((P/'display/display-context.json').read_text());native=P/'RetainedSensorJointsR38.FCStd'
assert sha(native)==r['native_sha256']==v['native_sha256']==e['native_sha256']==c['native_sha256']
assert r['all_static_screens_clear']and v['all_listed_loading_and_tool_poses_clear']and v['all_joint_six_direction_samples_blocked_within_2mm']and v['all_key_rotation_samples_blocked_within_2degrees']and e['all_valid_single_solid_volume_bounds_and_sample_checks_pass']
assert sha(ROOT/'hardware/cad/pack-assembly-r37/power-f/ConditionalPackPowerR37.FCStd')==r['source_R37F_sha256']==v['source_R37F_sha256']
for report,field,name in [(r,'builder_sha256','retain_sensor_joints_r38.py'),(v,'reviewer_sha256','review_sensor_joint_loading_r38.py'),(c,'exporter_sha256','export_sensor_retention_r38.py'),(e,'exporter_sha256','export_sensor_exchange_r38.py')]:assert sha(P/'executed-tools'/name)==report[field]
assert sha(ROOT/'hardware/bom.csv')=='d5424d0536840bd3b555c439a129c0271b19b1cfbb3b94f1e1709e57cd63f05c'
files={str(p.relative_to(ROOT)):sha(p)for p in sorted(P.rglob('*'))if p.is_file()and p.name!='.DS_Store'and p.suffix not in ['.pyc','.FCStd1']}
bindings=['hardware/cad/joint-retention-r38/README.md','hardware/cad/pack-assembly-r37/power-f/geometry-report.json','hardware/design/pack-assembly-r37/current-review.json','hardware/pcb/pack-pigtail-r35/candidate-f/system-native.xml','hardware/pcb/pack-pigtail-r35/candidate-f/body/body-r35.kicad_pcb','hardware/cables/pack-adapter-r37/pack-adapter-r37.yml','hardware/cables/pack-adapter-r37/logical-review.json','developer-docs/docs/sensor-retention-r38.md','assembly-docs/sensor-retention-r38.md','developer-docs/docs/assets/prototype-r2/sensor-retention-r38-c.png','developer-docs/docs/assets/prototype-r2/sensor-retention-r38-c-source.json','hardware/bom.csv']
out={'indexed_at_utc':datetime.now(timezone.utc).isoformat(),'indexer_sha256':sha(Path(__file__)),'files_sha256':files,'external_bindings_sha256':{n:sha(ROOT/n)for n in bindings},'current':{'sensor_joint_retention':'R38 C','parent':'R37 F conditional power / body anchor B','electrical_partner':'R35 F','wiring_recipe':'R37 conditional pack adapter','battery_selection':'OPEN'},'checks':{'installed_new_part_pairs':r['static_pairs'],'source_object_shapes_retained':v['source_roles_conserved'],'listed_loading_poses':sum(len(q['poses'])for q in v['staged_loading']),'generic_tool_poses':len(v['generic_tool']['poses']),'five_joint_six_direction_hard_blockers':True,'tab_rotation_hard_blockers':True,'named_hub_regions_source_material_conserved':True,'development_STEP_readback_scope':'Valid single solids/volume/bounds and bidirectional finite vertex/edge-midpoint samples; exact hub Boolean material equivalence not claimed'},'prototype_build_consideration_ready':False,'remaining_design':['Power mate and two power lap restraints','Complete loose-end body/hub loading, flange termination and connected cover/service sequence','Actual pad/joint attachment and preload, key/pilot/torque/tolerances and pack/mate receiving inputs','Motor/dock harnesses, flange loads/compliance and seals','Consolidated source/exports and practical first-build/commissioning package'],'scope':'Scoped nominal sensor-joint retention only. Finite installed/loading/tool/blocker samples and material witnesses are not strength, load/torque, joint/pad creep, actual fastener/tool, manufacturing or physical acceptance. Existing wiring/boards/exterior/motor preserved. No purchase, BOM adoption, battery selection, commit or energized work.'}
target=ROOT/'hardware/design/joint-retention-r38/current-review.json';target.parent.mkdir(parents=True,exist_ok=True);target.write_text(json.dumps(out,indent=2)+'\n');print('Indexed R38',len(files),'current artifacts and',len(bindings),'external bindings; full prototype proposal remains unfinished.',flush=True)
