researchanddesire/rad-project-template/tools/freeze_pack_r32.py

"""Freeze current pack-retention checkpoint without claiming full prototype."""
from pathlib import Path
import json,hashlib,shutil,zipfile,datetime
ROOT=Path(__file__).resolve().parents[1];P=ROOT/'hardware/cad/pack-retention-r32';E=P/'candidate-e';sha=lambda p:hashlib.sha256(p.read_bytes()).hexdigest();read=lambda p:json.loads(p.read_text());r=read(E/'geometry-report.json');v=read(E/'saved-review.json');s=read(E/'assembly-screen.json');f=read(E/'freeplay-review.json');close=read(E/'close-view-meshes.json');ui=read(E/'PackRetentionR32-review.json');notes=read(P/'source-notes.json')
assert sha(E/'PackRetentionR32.FCStd')==r['native_sha256']==v['native_sha256']==s['native_sha256']==f['native_sha256']==close['native_sha256']==ui['source_native_sha256']
assert sha(E/'geometry-report.json')==v['geometry_report_sha256']==f['geometry_report_sha256']and sha(E/'saved-review.json')==s['saved_review_sha256']==close['saved_review_sha256']
assert len(v['saved_roles'])==176 and len(v['source_roles_conserved'])==162 and not v['external_document_links']and v['new_pairs_tested']==1998 and v['rigid_vs_reservation_pairs']==492
assert not v['unexpected_intersections']and not v['unexpected_rigid_vs_reservation_intersections']and not r['unexpected_intersections']and not r['unexpected_rigid_vs_module_reservation_intersections']
coverage=read(E/'body-group-coverage.json');assert coverage['complete_physical_body_group_matches_native_inspection']and coverage['native_sha256']==r['native_sha256']and coverage['assembly_screen_sha256']==sha(E/'assembly-screen.json')and coverage['physical_component_envelope_count']==64 and len(coverage['non_body_footprints'])==1 and coverage['non_body_footprints'][0]['ref']=='JP1'
assert s['all_listed_screens_clear']and len(s['module_roles'])==9 and s['body_PCB_group_count']==coverage['moving_group_including_substrate_count']==65 and len(s['cap_vs_new_pack_parts_listed_poses'])==20 and len(s['module_common_position_studies'])==6 and all(q['blocked']for q in s['gauge_only_frame_blocking_probes'])
expected={'pack_module_top_loading_PCB_lid_waiting':9,'lid_top_loading_at_Y_plus2_PCB_waiting':8,'lid_rearward_tongue_engagement':6,'pack_lid_screw_listed_approach':5,'body_PCB_top_loading_pack_lid_fitted':8,'original_PCB_keeper_top_loading':8,'rigid_cartridge_vs_body_only_harnesses_waiting':21,'motor_module_vs_new_pack_parts':12}
assert {n:len(q)for n,q in s['assembly_stages'].items()}==expected
assert f['all_six_translation_probes_keep_sensors_out_of_first_contact']and len(f['rows'])==6 and len(f['included_sensor_and_process_roles'])==8 and all(q['sensor_minimum_native_gap_at_first_gauge_sample_mm']>=.05 for q in f['rows'])
assert abs(v['removal_outside_declared_tools_mm3'])<1e-4 and all(abs(q['lost_mm3'])<1e-5 for q in v['protected_material_witnesses'].values())
assert r['new_fasteners']==1 and set(r['replaced_roles'])=={'TipReadyCarrierR26'}and len(r['new_roles'])==12
assert 'NarrowPackAllowance'not in r['parts']and r['co_moving_size_reservations']['NarrowPackAllowance']['volume_mm3']==4522
assert notes['battery_selection']=='OPEN'and sha(ROOT/'hardware/bom.csv')=='d5424d0536840bd3b555c439a129c0271b19b1cfbb3b94f1e1709e57cd63f05c'
assert sha(ROOT/'hardware/pcb/flange-access-r28/candidate-s/body/body-r28.kicad_pcb')=='19f0c9b20d4b6e6c43636076531297af3eab12effb196b8ce46c807de477491b'
assert sha(ROOT/'hardware/pcb/flange-access-r28/candidate-s/flange/flange-r28.kicad_pcb')=='521bbffad5ad2ea960973a6650904ff64e906639b86408db8227b640d531e542'
assert sha(ROOT/'hardware/cad/buttons-r31/candidate-d/ButtonsR31.FCStd')==r['source_R31_native_sha256']==v['source_R31_native_sha256']
for candidate in ['a','b','c','d','e']:
 folder=P/('candidate-'+candidate);q=read(folder/'geometry-report.json');assert sha(folder/'executed-tools/retain_pack_r32.py')==q['builder_sha256']
assert len(read(P/'candidate-a/geometry-report.json')['unexpected_intersections'])==4 and len(read(P/'candidate-b/geometry-report.json')['unexpected_intersections'])==2
assert not read(P/'candidate-c/assembly-screen.json')['all_listed_screens_clear']and not read(P/'candidate-c/freeplay-review.json')['all_six_translation_probes_keep_sensors_out_of_first_contact']
assert read(P/'candidate-d/geometry-report.json')['unexpected_rigid_vs_module_reservation_intersections']
for tool,record,key in [('review_pack_r32.py',v,'reviewer_sha256'),('review_pack_freeplay_r32.py',f,'reviewer_sha256'),('review_pack_board_coverage_r32.py',coverage,'reviewer_sha256'),('export_pack_close_r32.py',close,'exporter_sha256'),('configure_pack_r32_view.py',ui,'configurator_sha256')]:assert sha(E/'executed-tools'/tool)==record[key]
assert sha(E/'PackRetentionR32-review.FCStd')==ui['review_copy_sha256']and ui['all_non_GUI_archive_members_unchanged']
with zipfile.ZipFile(E/'PackRetentionR32.FCStd')as a,zipfile.ZipFile(E/'PackRetentionR32-review.FCStd')as b:
 for n,h in ui['geometry_archive_entries_sha256'].items():assert hashlib.sha256(a.read(n)).hexdigest()==hashlib.sha256(b.read(n)).hexdigest()==h
for n,h in dict(v['new_meshes_sha256'],**v['native_X_nonpositive_section_meshes_sha256'],**close['meshes_sha256']).items():assert sha(E/n)==h
for q in notes['references']:assert sha(P/q['local'])==q['sha256']and(P/q['local']).read_bytes().startswith(b'%PDF')
figure=read(ROOT/'developer-docs/docs/assets/prototype-r2/pack-retention-r32-e-source.json');assert figure['native_sha256']==r['native_sha256']and figure['saved_review_sha256']==sha(E/'saved-review.json')and figure['assembly_screen_sha256']==sha(E/'assembly-screen.json')and figure['freeplay_review_sha256']==sha(E/'freeplay-review.json')and figure['close_view_meshes_sha256']==sha(E/'close-view-meshes.json')
assert sha(E/'executed-tools/render_pack_r32.py')==figure['renderer_sha256']
for n,h in figure['native_meshes_sha256'].items():assert sha(E/n)==h
status={'current_candidate':'candidate-e','native_sha256':r['native_sha256'],'geometry_ready_for_review':True,'full_prototype_proposal_ready':False,'new_fasteners':1,'battery_selection':'OPEN','pack_finished_size_gauge_xyz_mm':[18,33,6],'source_pack_size_reservation_xyz_mm':[19,34,7],'sensor_head_entries_xyz_mm':[q['head_start_xyz_mm']for q in r['sensors']],'counts':{'saved_roles_including_three_reservations':176,'source_roles_conserved':162,'new_physical_pairs':1998,'rigid_vs_reservation_pairs':492,'listed_assembly_poses':sum(expected.values()),'cap_poses':20,'common_module_position_probes':6,'gauge_only_frame_blockers':6,'freeplay_axes':6,'head_lead_contact_film_roles_in_freeplay':8},'minimum_sensor_gap_at_first_gauge_intersection_sample_mm':min(q['sensor_minimum_native_gap_at_first_gauge_sample_mm']for q in f['rows']),'remaining_proposal_work':['Complete pack/NTC adapter, motor and dock harnesses with restraint/connected loading','At least one feasible protected-pack option in matched design; leave selection OPEN','Flange removal-load path/compliance and seal/material/process interfaces','Current complete circuit/firmware/fabrication review and consolidated first-build/test package'],'first_build_unperformed':['Matched pack limits/finished geometry/expansion and retention','Actual fastener/profile/thread/locking/material/fit','Dummy load/deflection and actual sensor stress/vibration','Cell-compatible tape/bond, thermal gradients/lag and charge-inhibit commissioning'],'scope':'Fresh native geometry and finite rigid/loading/freeplay probes only. Pack is a size gauge; three distinct sizing/clearance reservations preserved.0.07mm film boxes are process space, factory stubs are not cut lengths. No load, soft-pouch deformation, swelling, continuous connected harness, actual thermal/physical or wear acceptance; no procurement or BOM edit.'};(P/'review-status.json').write_text(json.dumps(status,indent=2)+'\n');shutil.copyfile(Path(__file__),E/'executed-tools/freeze_pack_r32.py')
external=['hardware/bom.csv','hardware/cad/buttons-r31/artifact-index.json','hardware/cad/buttons-r31/candidate-d/ButtonsR31.FCStd','hardware/cad/buttons-r31/candidate-d/geometry-report.json','hardware/cad/buttons-r31/candidate-d/saved-review.json','hardware/cad/buttons-r31/candidate-d/assembly-screen.json','hardware/cad/tip-support-r26/candidate-f/geometry-report.json','hardware/pcb/flange-access-r28/artifact-index.json','hardware/pcb/flange-access-r28/candidate-s/system-native.xml','hardware/pcb/flange-access-r28/candidate-s/layout-inspection.json','hardware/pcb/flange-access-r28/candidate-s/body/body-r28.kicad_pcb','hardware/pcb/flange-access-r28/candidate-s/flange/flange-r28.kicad_pcb','hardware/design/charge-cutoff-r0.json','developer-docs/docs/pack-retention-r32.md','assembly-docs/pack-retention-r32.md','developer-docs/docs/assets/prototype-r2/pack-retention-r32-e.png','developer-docs/docs/assets/prototype-r2/pack-retention-r32-e-source.json','tools/render_mechanical_r2.py']
files={str(q.relative_to(P)):sha(q)for q in sorted(P.rglob('*'))if q.is_file()and q!=P/'artifact-index.json'and q.suffix not in ['.pyc','.lck']and q.name!='.DS_Store'and '__pycache__'not in q.parts};index={'frozen_at':datetime.datetime.now(datetime.timezone.utc).isoformat(),'current':'candidate-e','freezer_sha256':sha(Path(__file__)),'files_sha256':files,'external_bindings_sha256':{n:sha(ROOT/n)for n in external},'state':'Conditional pack/dual-NTC retention geometry checkpoint; complete prototype proposal unfinished','scope':status['scope']};(P/'artifact-index.json').write_text(json.dumps(index,indent=2)+'\n')
for n,h in index['files_sha256'].items():assert sha(P/n)==h,n
for n,h in index['external_bindings_sha256'].items():assert sha(ROOT/n)==h,n
print('R32 frozen',len(files),'files /',len(external),'bindings;176roles/1998physical pairs/492reservation pairs and listed scopes pass. Full prototype proposal unfinished.',flush=True)
