researchanddesire/rad-project-template/tools/freeze_flange_pack_r33.py

"""Freeze the scoped R33 checkpoint; never imply whole-prototype readiness."""
from pathlib import Path
import json,hashlib,shutil,zipfile,datetime
ROOT=Path(__file__).resolve().parents[1];P=ROOT/'hardware/cad/battery-fit-r33';F=P/'candidate-f';sha=lambda p:hashlib.sha256(p.read_bytes()).hexdigest();read=lambda p:json.loads(p.read_text());r=read(F/'geometry-report.json');v=read(F/'saved-review.json');f=read(F/'freeplay-review.json');c=read(F/'display-context.json');ui=read(F/'FlangePackR33-review.json');figure=read(ROOT/'developer-docs/docs/assets/prototype-r2/flange-pack-r33-f-source.json')
assert sha(F/'FlangePackR33.FCStd')==r['native_sha256']==v['native_sha256']==f['native_sha256']==c['native_sha256']==ui['source_native_sha256']==figure['native_sha256']=='c5edbbf09534bf635547cf0431879f01326af78a55eb9bd0b8e72c0b98368618'
assert sha(F/'geometry-report.json')==v['geometry_report_sha256']==f['geometry_report_sha256']==figure['geometry_report_sha256']
assert sha(F/'saved-review.json')==c['saved_review_sha256']==figure['saved_review_sha256']and sha(F/'freeplay-review.json')==figure['freeplay_review_sha256']and sha(F/'display-context.json')==figure['context_report_sha256']
assert len(v['saved_roles'])==177 and len(v['source_roles_conserved'])==161 and v['new_physical_pairs']==2171 and v['rigid_reservation_pairs']==495 and not v['external_document_links']
assert not v['unexpected_intersections']and not v['unexpected_reservation_intersections']and not r['unexpected_intersections']and not r['unexpected_reservation_intersections']
assert v['source_right_hub_removed_mm3']<1e-4 and v['right_hub_with_tray_solids']==1 and v['all_listed_screens_clear']
assert sum(len(q)for q in v['assembly_stages'].values())==63 and len(v['module_common_position_studies'])==6 and len(v['generic_rear_driver_shaft_studies'])==2
assert len(f['rows'])==6 and len(f['included_sensor_and_process_roles'])==8 and f['all_six_probes_frame_before_sensors_and_cover']
assert all(q['sensor_minimum_gap_at_first_gauge_frame_sample_mm']>=.05 and q['gauge_cover_minimum_gap_at_first_gauge_frame_sample_mm']>=.05 for q in f['rows'])
assert r['battery_selection']=='OPEN'and read(ROOT/'hardware/design/battery-fit-r33/options-screen.json')['battery_selection']=='OPEN'
assert sha(ROOT/'hardware/bom.csv')=='d5424d0536840bd3b555c439a129c0271b19b1cfbb3b94f1e1709e57cd63f05c'
assert sha(ROOT/'hardware/pcb/flange-access-r28/candidate-s/body/body-r28.kicad_pcb')=='19f0c9b20d4b6e6c43636076531297af3eab12effb196b8ce46c807de477491b'
assert sha(ROOT/'hardware/pcb/flange-access-r28/candidate-s/flange/flange-r28.kicad_pcb')=='521bbffad5ad2ea960973a6650904ff64e906639b86408db8227b640d531e542'
old=ROOT/'hardware/cad/pack-retention-r32';oldindex=read(old/'artifact-index.json')
# The current fresh native review already checks source conservation. Bind the
# unchanged prior index and actual current source inputs; do not re-read all
# historical display exports (unrelated to this checkpoint's acceptance).
assert sha(old/'artifact-index.json')==read(ROOT/'hardware/design/battery-fit-r33/initial-screen.json')['source_R32_index_sha256']
assert sha(old/'candidate-e/PackRetentionR32.FCStd')==r['source_R32_native_sha256']
for folder in ['candidate-d','candidate-e','candidate-f']:
 q=read(P/folder/'geometry-report.json');assert sha(P/folder/'FlangePackR33.FCStd')==q['native_sha256'];assert sha(P/folder/'executed-tools/retain_flange_pack_r33.py')==q['builder_sha256']
assert len(read(P/'candidate-d/geometry-report.json')['unexpected_intersections'])==4 and read(P/'candidate-d/geometry-report.json')['tray_solids']==3
assert not read(P/'candidate-e/geometry-report.json')['unexpected_intersections']and read(P/'candidate-e/geometry-report.json')['source_right_hub_removed_mm3']>7
for folder,count in [('screen-a',0),('screen-b',0),('screen-c',3)]:
 q=read(P/folder/'pose-screen.json');assert q['clear_pose_count']==count;tool='screen_flange_pack_r33.py'if folder=='screen-c'else'screen_battery_fit_r33.py';assert sha(P/folder/'executed-tools'/tool)==q['screener_sha256']
for tool,record,key in [('review_flange_pack_r33.py',v,'reviewer_sha256'),('review_flange_pack_freeplay_r33.py',f,'reviewer_sha256'),('export_flange_pack_context_r33.py',c,'exporter_sha256'),('configure_flange_pack_r33_view.py',ui,'configurator_sha256'),('render_flange_pack_r33.py',figure,'renderer_sha256')]:assert sha(F/'executed-tools'/tool)==record[key]
for n,h in dict(v['meshes_sha256'],**v['native_Y_at_least_minus18_section_meshes_sha256'],**c['meshes_sha256'],**c['sensor_section_meshes_sha256']).items():assert sha(F/n)==h
for n,h in figure['native_meshes_sha256'].items():assert sha(F/n)==h
assert sha(F/'FlangePackR33-review.FCStd')==ui['review_copy_sha256']and ui['all_non_GUI_archive_members_unchanged']
# The visibility configurator verified every non-GUI archive member. Its exact
# source/copy hashes above bind that proof without another decompression pass.
status={'current_candidate':'candidate-f','native_sha256':r['native_sha256'],'geometry_ready_for_review':True,'full_prototype_proposal_ready':False,'battery_selection':'OPEN','pack_published_body_XYZ_mm':[33,8,20],'pack_minimum_XYZ_mm':[7,-24,-10],'pack_excludes_lead_and_connector':True,'new_fasteners':2,'source_right_hub_material_conserved':True,'right_hub_tray_solids':1,'counts':{'saved_roles_including_three_reservations':177,'source_roles_conserved':161,'new_physical_pairs':2171,'rigid_reservation_pairs':495,'listed_loading_and_cover_positions':63,'common_module_positions':6,'generic_driver_shafts':2,'freeplay_axes':6},'minimum_sensor_gap_at_first_gauge_frame_sample_mm':min(q['sensor_minimum_gap_at_first_gauge_frame_sample_mm']for q in f['rows']),'minimum_gauge_cover_gap_at_first_gauge_frame_sample_mm':min(q['gauge_cover_minimum_gap_at_first_gauge_frame_sample_mm']for q in f['rows']),'remaining_proposal_work':['Complete real pack/NTC adapter, motor and dock harnesses with supported connected assembly','Match at least one protected finished-pack drawing/leads/connector and electrical/charge limits; keep battery selection OPEN','Flange removal-load path/compliance and seal/material/process interfaces','Current complete circuit/firmware/fabrication review and consolidated first-build/test package'],'scope':v['scope']};(P/'review-status.json').write_text(json.dumps(status,indent=2)+'\n');shutil.copyfile(Path(__file__),F/'executed-tools/freeze_flange_pack_r33.py')
external=['hardware/bom.csv','hardware/cad/pack-retention-r32/artifact-index.json','hardware/cad/pack-retention-r32/candidate-e/PackRetentionR32.FCStd','hardware/cad/pack-retention-r32/candidate-e/geometry-report.json','hardware/cad/pack-retention-r32/candidate-e/body-group-coverage.json','hardware/cad/pack-retention-r32/source-notes.json','hardware/cad/harness-support-r30/parked-d/parking-review.json','hardware/pcb/flange-access-r28/artifact-index.json','hardware/pcb/flange-access-r28/candidate-s/system-native.xml','hardware/pcb/flange-access-r28/candidate-s/layout-inspection.json','hardware/pcb/flange-access-r28/candidate-s/body/body-r28.kicad_pcb','hardware/pcb/flange-access-r28/candidate-s/flange/flange-r28.kicad_pcb','hardware/design/charge-cutoff-r0.json','hardware/design/battery-fit-r33/initial-screen.json','hardware/design/battery-fit-r33/options-screen.json','developer-docs/docs/flange-pack-r33.md','assembly-docs/flange-pack-r33.md','developer-docs/docs/assets/prototype-r2/flange-pack-r33-f.png','developer-docs/docs/assets/prototype-r2/flange-pack-r33-f-source.json','tools/render_mechanical_r2.py']
files={str(q.relative_to(P)):sha(q)for q in sorted(P.rglob('*'))if q.is_file()and q!=P/'artifact-index.json'and q.suffix not in ['.pyc','.lck']and q.name!='.DS_Store'and '__pycache__'not in q.parts};index={'frozen_at':datetime.datetime.now(datetime.timezone.utc).isoformat(),'current':'candidate-f','freezer_sha256':sha(Path(__file__)),'files_sha256':files,'external_bindings_sha256':{n:sha(ROOT/n)for n in external},'state':'Published pack body-size feasibility and right-wing tray checkpoint; full prototype proposal unfinished','scope':v['scope']};(P/'artifact-index.json').write_text(json.dumps(index,indent=2)+'\n')
for n,h in index['files_sha256'].items():assert sha(P/n)==h,n
for n,h in index['external_bindings_sha256'].items():assert sha(ROOT/n)==h,n
print('R33 frozen',len(files),'files /',len(external),'bindings; scoped checks pass. Battery OPEN, BOM/source R32 unchanged. Whole proposal unfinished.',flush=True)
