researchanddesire/rad-project-template/tools/freeze_harness_r30.py

"""Freeze the R30 anchor and loose-end assembly checkpoint, not a full build."""
from pathlib import Path
import json,hashlib,shutil,zipfile
ROOT=Path(__file__).resolve().parents[1];P=ROOT/'hardware/cad/harness-support-r30';B=P/'candidate-b';D=P/'parked-d';sha=lambda p:hashlib.sha256(p.read_bytes()).hexdigest();read=lambda p:json.loads(p.read_text())
r=read(B/'geometry-report.json');v=read(B/'saved-review.json');park=read(D/'parking-review.json');fresh=read(D/'saved-review.json');transport=read(B/'transport-centering.json');interfaces=read(B/'mechanical-interface-review.json');bad=read(B/'assembly-screen.json')
assert sha(B/'HarnessSupportR30.FCStd')==r['native_sha256']==v['native_sha256']==park['source_R30_native_sha256']==fresh['source_R30_native_sha256']==transport['native_sha256']==interfaces['native_sha256']
assert sha(B/'geometry-report.json')==v['geometry_report_sha256']and not v['unexpected_intersections']and len(v['saved_roles'])==153 and len(v['source_roles_conserved'])==148 and not v['external_document_links']and v['forced_new_pairs_tested']==750
assert v['all_new_static_keeper_capture_tool_screens_clear']and len(v['keeper_listed_approach_poses'])==11 and all(q['blocked_as_rigid']for q in v['pads_rigid_translation_blocking_witnesses'])
assert sha(D/'ParkedHarnessR30.FCStd')==park['native_sha256']==fresh['native_sha256']and sha(D/'parking-review.json')==fresh['parking_review_sha256']and park['all_listed_geometry_screens_clear']and fresh['all_original_listed_stage_screens_clear']
assert fresh['new_wire_pairs_tested']==1435 and len(fresh['source_current_roles_conserved'])==153 and not fresh['unexpected_intersections']and not fresh['external_document_links']
assert len(park['left_hub_listed_poses'])==len(park['right_hub_listed_poses'])==9 and len(park['populated_flange_listed_poses'])==11
assert any(q['hits']for q in bad['left_hub_listed_poses'])and not bad['all_listed_poses_clear']
assert transport['centered_poses_clear']and all(q['source_material_lost_mm3']<1e-5 for q in interfaces['witnesses'].values())
for folder,file,proofname in [(B,'HarnessSupportR30','HarnessSupportR30-review.json'),(D,'ParkedHarnessR30','ParkedHarnessR30-review.json')]:
 proof=read(folder/proofname);assert sha(folder/(file+'.FCStd'))==proof['source_native_sha256']and sha(folder/(file+'-review.FCStd'))==proof['review_copy_sha256']
 with zipfile.ZipFile(folder/(file+'.FCStd'))as a,zipfile.ZipFile(folder/(file+'-review.FCStd'))as b:
  for name,digest in proof['geometry_archive_entries_sha256'].items():assert hashlib.sha256(a.read(name)).hexdigest()==hashlib.sha256(b.read(name)).hexdigest()==digest
for folder,tool,record,key in [(B,'support_harness_r30.py',r,'builder_sha256'),(B,'review_harness_r30.py',v,'reviewer_sha256'),(D,'park_harness_r30.py',park,'builder_screener_sha256'),(D,'review_parked_harness_r30.py',fresh,'reviewer_sha256')]:assert sha(folder/'executed-tools'/tool)==record[key]
assert sha(ROOT/'hardware/bom.csv')=='d5424d0536840bd3b555c439a129c0271b19b1cfbb3b94f1e1709e57cd63f05c'
status={'installed_native_sha256':r['native_sha256'],'installed_saved_review_sha256':sha(B/'saved-review.json'),'parked_native_sha256':park['native_sha256'],'parked_saved_review_sha256':sha(D/'saved-review.json'),'geometry_ready_for_review':True,'full_prototype_proposal_ready':False,'accepted_order':'Thread loose flange ends, form/cure central pad externally, park free ends for hub closure, seat board, form/trim/terminate/mate flange loop, form/cure flange pad externally, slide keeper cup on and fit existing screw.','superseded_screens':{'finished_loop_hub_closure':'Fails; retained in candidate-b/assembly-screen.json.','generic_BoundBox_transport':'Invalid centering for trimmed shapes; current transport-centering.json uses actual optimal bounds.','parked_c_static':'Waiting covers were included; parked-d repeats the explicitly cover-absent stage.'},'counts':{'installed_roles':153,'unchanged_source_roles':148,'changed_part_comparisons':750,'keeper_approaches':11,'rigid_pad_blockers':12,'fresh_parked_source_roles':153,'parked_wire_comparisons':1435,'hub_poses_each_side':9,'populated_board_poses':11},'remaining':'Actual fixture/forming/termination/mating and continuous/service motion; cure/jacket adhesion/creep/loads/actual fit; controls/registration, remaining harnesses, pack/NTC retention, flange loads/compliance, seals/materials/process and complete first-build package. Battery OPEN; no physical prototype or procurement.'}
(P/'review-status.json').write_text(json.dumps(status,indent=2)+'\n');shutil.copyfile(Path(__file__),B/'executed-tools/freeze_harness_r30.py')
external=['hardware/bom.csv','hardware/cad/interboard-r29/artifact-index.json','hardware/cad/interboard-r29/candidate-e/InterboardR29.FCStd','hardware/cad/interboard-r29/candidate-e/geometry-report.json','hardware/cad/interboard-r29/candidate-e/saved-review.json','hardware/cad/interboard-r29/review-e/wire-plan.json','hardware/cad/interboard-r29/review-e/plan-review.json','hardware/cad/flange-controls-r27/artifact-index.json','hardware/cad/flange-controls-r27/candidate-d/FlangeCradleR27.FCStd','hardware/cad/flange-controls-r27/candidate-d/geometry-report.json','hardware/pcb/flange-access-r28/artifact-index.json','hardware/pcb/flange-access-r28/candidate-s/system-native.xml','hardware/pcb/flange-access-r28/candidate-s/body/body-r28.kicad_pcb','hardware/pcb/flange-access-r28/candidate-s/flange/flange-r28.kicad_pcb','hardware/cables/interboard-r29/interboard-r29.yml','hardware/cables/interboard-r29/logical-review.json','developer-docs/docs/harness-support-r30.md','assembly-docs/harness-support-r30.md','hardware/cables/harness-support-r30/README.md','developer-docs/docs/assets/prototype-r2/harness-support-r30-b.png','developer-docs/docs/assets/prototype-r2/harness-support-r30-b-source.json']
figure=read(ROOT/'developer-docs/docs/assets/prototype-r2/harness-support-r30-b-source.json');assert figure['native_sha256']==r['native_sha256']and figure['saved_review_sha256']==sha(B/'saved-review.json')
for key,folder in [('R29_wire_meshes_sha256','hardware/cad/interboard-r29/candidate-e'),('R27_context_meshes_sha256','hardware/cad/flange-controls-r27/candidate-d')]:
 for name,digest in figure[key].items():f=ROOT/folder/name;assert sha(f)==digest;external.append(str(f.relative_to(ROOT)))
for name,digest in v['changed_role_meshes_sha256'].items():assert sha(B/name)==digest
files={str(f.relative_to(P)):sha(f)for f in sorted(P.rglob('*'))if f.is_file()and f!=P/'artifact-index.json'and f.suffix not in ['.pyc','.lck']and f.name!='.DS_Store'and '__pycache__'not in f.parts}
index={'date':'2026-11-01','current_installed':'candidate-b','current_assembly_stage':'parked-d','state':'Captured wire-anchor geometry and staged assembly checkpoint; complete prototype build proposal unfinished','freezer_sha256':sha(Path(__file__)),'files_sha256':files,'external_bindings_sha256':{name:sha(ROOT/name)for name in sorted(set(external))},'review_status_sha256':sha(P/'review-status.json'),'scope':'Fresh native saved geometry, source material/curve conservation, changed/new-wire static comparisons and finite staged positions. Rigid pad capture does not establish soft grip/creep/load. Isolated centered pad passage is not whole connected harness loading. Proposed externally cured overmolds and bench coupon targets unperformed. No actual forming/mating/service/cure/current/RF/seal/physical acceptance, procurement or human BOM edit. Battery OPEN.'}
(P/'artifact-index.json').write_text(json.dumps(index,indent=2)+'\n')
for name,digest in index['files_sha256'].items():assert sha(P/name)==digest,name
for name,digest in index['external_bindings_sha256'].items():assert sha(ROOT/name)==digest,name
print('R30 frozen:',len(files),'files /',len(index['external_bindings_sha256']),'external bindings;153installed roles/750changed comparisons and1435parked wire comparisons pass scoped checks.')
