researchanddesire/rad-project-template/tools/freeze_body_r16.py

"""Freeze R16U's scoped source/route/fit review without releasing fabrication."""
from pathlib import Path
import json,hashlib,shutil
ROOT=Path(__file__).resolve().parents[1];OUT=ROOT/'hardware/pcb/route-r16';P=OUT/'candidate-u';sha=lambda p:hashlib.sha256(p.read_bytes()).hexdigest();read=lambda n:json.loads((P/n).read_text());a=read('saved-copper-audit.json');inv=read('drill-paste-inventory.json');fit=read('mechanical-fit.json');layout=read('layout-inspection.json');c=read('circuit-conservation.json');bp=P/'flange/flange-r16.kicad_pcb'
assert sha(bp)==a['native_board_sha256']==inv['native_board_sha256']==layout['boards']['flange']['native_board_sha256'];assert a['DRC']=={'violations':0,'unconnected':0,'footprint_errors':0}and not a['pin_net_mismatches'];assert a['electrical_pad_entries_checked']==119 and len(a['explicit_native_NC_pins_kept_copper_netless'])==14
assert inv['counts']=={'all_through_vias':39,'all_native_copper_or_paste_pad_shapes':125,'vias_drilling_SMD_copper':0,'vias_drilling_paste':0};assert sha(P/'route-geometry.json')==inv['native_geometry_sha256'];assert sha(P/'flange/routed-native-drc.txt')==a['drc_sha256'];assert sha(bp.with_suffix('.kicad_pro'))==a['project_sha256'];assert sha(P/'flange/flange-native.xml')==a['native_flange_xml_sha256'];assert sha(P/'layout-inspection.json')==a['native_inspection_sha256']==fit['inspection_sha256']
assert fit['new_primary_pairs']==5805 and not fit['primary_intersections'];assert {(m['mate'],m['target'])for m in fit['nominal_mate_intersections']}=={('J2','DropInCarrier'),('J2','DropInPCBKeeper'),('J3','DropInPCBKeeper'),('J5','DropInPCBKeeper')}
assert len(fit['retained_fixed_roles'])==20 and len(fit['new_primary_roles'])==90;assert all(u['samples_without_In1_GND']==0 and u['signal_vias']==0 for u in a['USB'].values());assert a['In1_signal_tracks']==0
assert c['native_component_count']==94 and c['native_pin_net_function_type_nodes']==338 and c['original_pin_net_function_type_nodes_unchanged']==318
assert sha(P/'system-native.xml')==c['new_system_XML_sha256'];baseline=OUT/'candidate-a'
for f,h in c['current_schematic_sha256'].items():assert sha(P/f)==h and sha(baseline/f)==c['source_schematic_sha256'][f]
for domain in ['body','flange']:
 assert sha(P/domain/(domain+'-r16.kicad_pcb'))==layout['boards'][domain]['native_board_sha256'];assert sha(baseline/domain/(domain+'-r16.kicad_pcb'))==layout['source_A_board_sha256'][domain]
 assert len(layout['boards'][domain]['placements'])=={'body':65,'flange':24}[domain]
 assert not layout['boards'][domain]['same_face_courtyard_overlaps']
body=(P/'body/placement-native-drc.txt').read_text();assert '** Found 0 DRC violations **'in body and '** Found 163 unconnected pads **'in body and '** Found 0 Footprint errors **'in body
assert (P/'input-power-path.json').read_bytes()==(P/'input-power-path-reproduced.json').read_bytes()
old=json.loads((ROOT/'hardware/pcb/route-r15/artifact-index.json').read_text());preserved=old['preserved_sources_sha256'].copy()
preserved['hardware/pcb/route-r15/candidate-t/flange/flange-r15.kicad_pcb']=json.loads((ROOT/'hardware/pcb/route-r15/candidate-t/saved-copper-audit.json').read_text())['native_board_sha256']
preserved['hardware/pcb/route-r15/candidate-t/body/body-r15.kicad_pcb']=old['preserved_sources_sha256']['hardware/pcb/split-r14/candidate-b/body/body-r14.kicad_pcb'];assert fit['R13_native_sha256']==preserved['hardware/cad/simple-assembly-r13/candidate-f/SimpleAssemblyR13.FCStd']
for f,h in preserved.items():assert sha(ROOT/f)==h,f
frozen=OUT/'tools';frozen.mkdir(exist_ok=True);sources=list((ROOT/'tools').glob('*r16.py'))+[ROOT/'tools'/n for n in ['pcb_r2_route.py','pcb_split_r12.py','kicad_sexp.py','route_geometry_r15.py','electronics_r0_generate.py']]
for f in sources:shutil.copyfile(f,frozen/f.name)
assets=ROOT/'developer-docs/docs/assets/prototype-r2';docs=[ROOT/'developer-docs/docs/body-placement-r16.md']+[assets/('flange-routing-r16'+s)for s in ['.svg','.png','-source.json']];files={str(f.relative_to(OUT)):sha(f)for f in sorted(OUT.rglob('*'))if f.is_file()and f.name not in ['artifact-index.json','freeze-log.txt']and not(f.name.startswith('~')or f.suffix in ['.lck','.kicad_prl'])and'__pycache__'not in f.parts}
out={'date':'2026-11-01','current':'R16U65body/24flange; flange0/0/0,body0/163/0; four nominal mate hits remain','freezer_sha256':sha(Path(__file__)),'artifact_files_sha256':files,'preserved_sources_sha256':preserved,'figure_and_doc_bindings_sha256':{str(f.relative_to(ROOT)):sha(f)for f in docs},'scope':'Current U native source/circuit/pad/copper/reference/drill geometry and read-only R13F context only. Earlier attempts include rejected findings and stale before-audit files; their hashes preserve history, not acceptance. No fresh GUI ERC, integrated CAD, complete body routing, installed harness/controls/tip/wing/material/process/build-proposal or physical acceptance. BatteryOPEN/humanBOMunchanged; no fabrication release.'};(OUT/'artifact-index.json').write_text(json.dumps(out,indent=2)+'\n');assert all(sha(OUT/f)==h for f,h in files.items());print(len(files),'R16 artifacts;',len(preserved),'preserved source bindings;',len(docs),'figure/doc bindings',flush=True)
