researchanddesire/rad-project-template/tools/freeze_frontload_r17_r18.py

"""Freeze the partial R17P and native R18A review checkpoints, not a release."""
from pathlib import Path
import json,hashlib,shutil
ROOT=Path(__file__).resolve().parents[1];P=ROOT/'hardware/pcb/route-r17/candidate-p';C=ROOT/'hardware/cad/pcb-integration-r18/candidate-a';sha=lambda p:hashlib.sha256(p.read_bytes()).hexdigest();read=lambda p:json.loads(p.read_text())
a=read(P/'saved-body-copper-audit.json');d=read(P/'body/native-drc.json');v=read(P/'drill-paste-inventory.json');r=read(C/'geometry-report.json');s=read(C/'saved-review.json');pose=read(P/'R18-pose-conservation.json');circuit=read(P/'circuit-conservation.json')
bp=P/'body/body-r17.kicad_pcb';cf=C/'PCBIntegrationR18.FCStd'
assert sha(bp)==a['native_board_sha256']==d['native_board_sha256']==v['native_board_sha256'];assert a['DRC']==d['counts']=={'violations':5,'unconnected':17,'footprint_errors':0};assert not a['pin_net_mismatches']and a['electrical_pad_entries_checked']==211 and len(a['explicit_native_NC_pins_kept_copper_netless'])==8
assert a['In2_signal_tracks']==0 and a['protected_seed_records_preserved']==250;assert a['local_B_power_reference']['sample_count']==1260 and a['local_B_power_reference']['samples_without_filled_In2_GND']==0
assert v['counts']=={'all_through_vias':106,'all_native_copper_or_paste_pad_shapes':238,'vias_drilling_SMD_copper':0,'vias_drilling_paste':0};assert sha(P/'body-native-geometry-all-layers.json')==v['native_geometry_sha256'];assert sha(P/'body/fresh-native-drc.txt')==d['native_report_sha256'];assert sha(P/'body/body-native.xml')==a['native_body_xml_sha256'];assert sha(P/'system-native.xml')==circuit['new_native_XML_sha256'];assert circuit['all_338_nodes_equal_R16U']and circuit['all_schematic_nominal_values_equal_R16U']
assert sha(cf)==r['native_sha256']==s['native_sha256']==pose['R18_native_sha256'];assert sha(C/'geometry-report.json')==s['geometry_report_sha256']==pose['R18_geometry_report_sha256'];assert sha(P/'layout-inspection.json')==pose['current_P_inspection_sha256']and pose['all_substrate_Fab_height_mate_envelopes_identical']
assert len(r['parts'])==110 and len(r['mates'])==7 and r['static_pairs_tested']==5995 and not r['unexpected_intersections']and not r['nominal_mate_intersections']and len(r['named_unqualified_screw_pilot_interfaces'])==2
assert len(r['board_drop_listed_poses'])==8 and all(not q['hits']for q in r['board_drop_listed_poses']);assert len(r['keeper_lowering_listed_poses'])==8 and all(not q['hits']for q in r['keeper_lowering_listed_poses']);assert len(r['cartridge_listed_poses'])==21 and all(q['body_hit_mm3']<1e-5 for q in r['cartridge_listed_poses'])
assert len(s['saved_roles'])==117 and len(s['native_PCB_part_envelopes_checked'])==88 and not s['external_document_links'];assert all(sha(C/f)==h for f,h in r['review_meshes_sha256'].items())
old=read(ROOT/'hardware/pcb/route-r16/artifact-index.json');preserved=old['preserved_sources_sha256'].copy();preserved['hardware/pcb/route-r16/candidate-u/flange/flange-r16.kicad_pcb']='04a9f9503ffcf402179143119b3c763902a31279b347218ac49ab9c9dba715c8';preserved['hardware/bom.csv']='d5424d0536840bd3b555c439a129c0271b19b1cfbb3b94f1e1709e57cd63f05c'
assert sha(P/'flange/flange-r17.kicad_pcb')==preserved['hardware/pcb/route-r16/candidate-u/flange/flange-r16.kicad_pcb']
for f,h in preserved.items():assert sha(ROOT/f)==h,f
for base,pattern,extra,docs in [
 (P.parent,'*r17.py',['pcb_r2_route.py','pcb_split_r12.py','electronics_r0_generate.py','kicad_sexp.py','freeze_frontload_r17_r18.py'],['developer-docs/docs/body-routing-r17.md']),
 (C.parent,'*r18.py',['render_mechanical_r2.py','freeze_frontload_r17_r18.py'],['developer-docs/docs/pcb-integration-r18.md','assembly-docs/r18-plug-access.md','developer-docs/docs/assets/prototype-r2/pcb-integration-r18.png','developer-docs/docs/assets/prototype-r2/pcb-integration-r18-source.json'])]:
  folder=base/'tools';folder.mkdir(exist_ok=True)
  for f in list((ROOT/'tools').glob(pattern))+[ROOT/'tools'/n for n in extra]:shutil.copyfile(f,folder/f.name)
  files={str(f.relative_to(base)):sha(f)for f in sorted(base.rglob('*'))if f.is_file()and f.name!='artifact-index.json'and f.suffix not in ['.kicad_prl','.lck']and not f.name.startswith('~')and'__pycache__'not in f.parts}
  out={'date':'2026-11-01','freezer_sha256':sha(Path(__file__)),'current':'R17Ppartialbody5viawarnings/17open/0foot; R18Anativeportedkeeper/fullernose','artifact_files_sha256':files,'doc_and_figure_bindings_sha256':{n:sha(ROOT/n)for n in docs},'preserved_sources_sha256':preserved,'scope':'Current exact saved-file review checkpoint. R17 routing incomplete; historical failures/logs preserve their own findings. R18 nominal geometry/listed rigid poses/native history only. No real wires, loads, controls/tip/wing completion, process/material/parts/physical acceptance or complete build proposal. Battery OPEN, human BOM unchanged. No fabrication release.'};(base/'artifact-index.json').write_text(json.dumps(out,indent=2)+'\n');assert all(sha(base/f)==h for f,h in files.items());print(base.name,len(files),'frozen files',flush=True)
